ETH-PBL/SwiftEagle/Hardware/Baseboard/Schematics.PDF

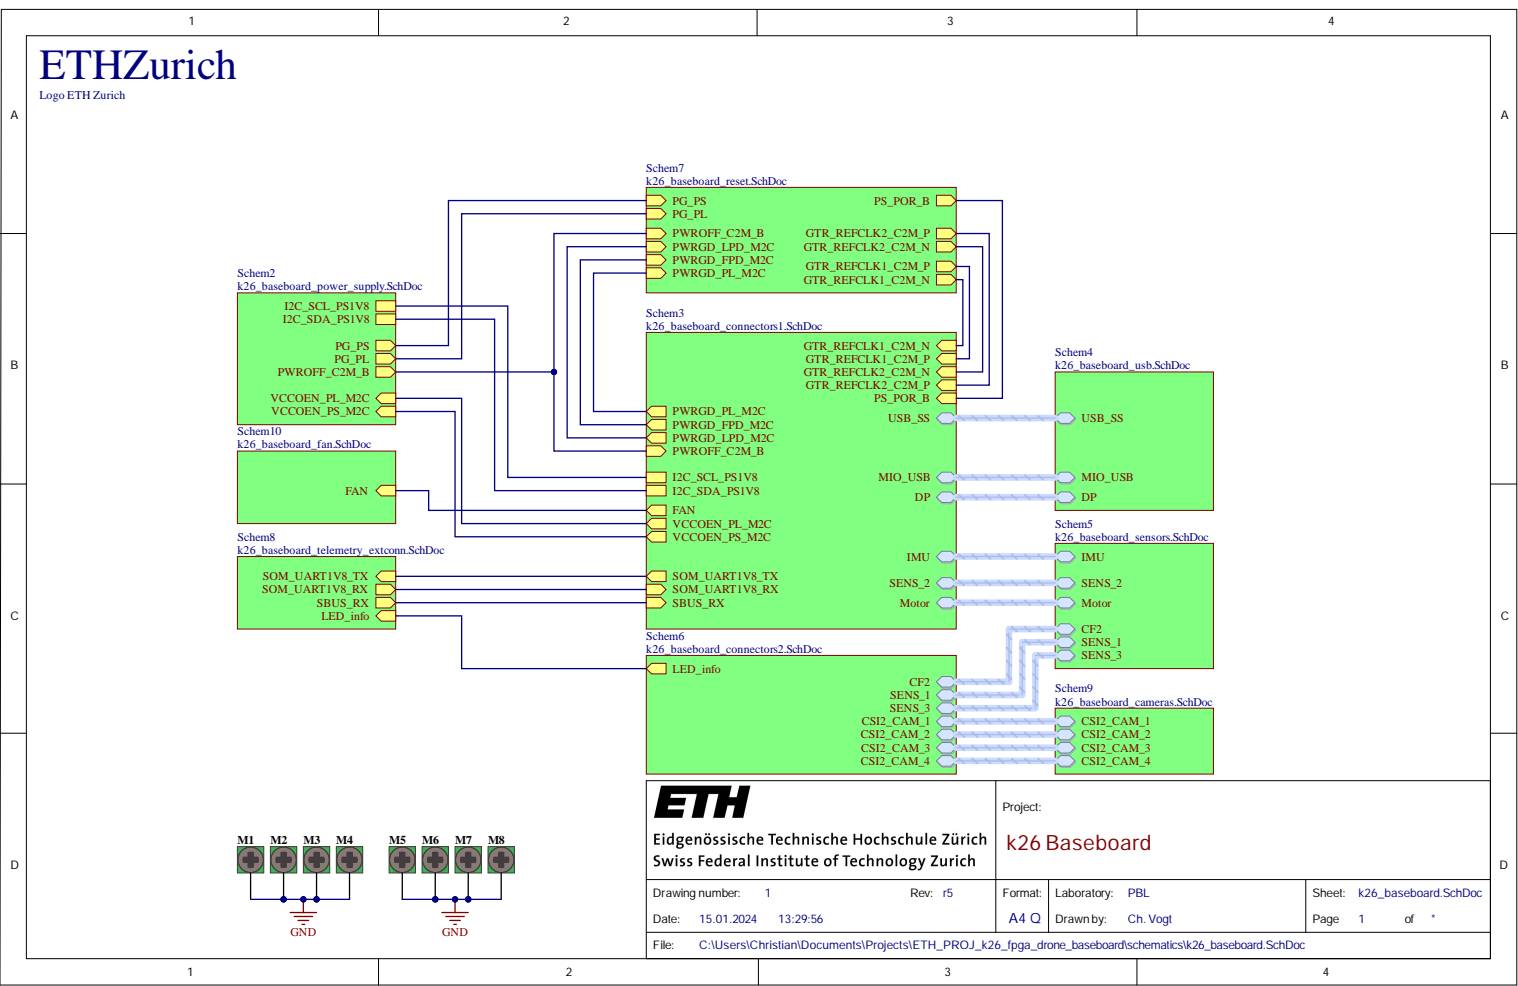
[picture p3: page 1]

ETHZurich Logo ETH Zurich

Project: k26 Baseboard

Drawing number: 1 Rev: r5 Date: 15.01.2024 13:29:56 | Format: A4 Q | Laboratory: PBL Drawn by: Ch.Vogt | Sheet: k26_baseboard.SchDoc Page 1 of *

C:\Users\Christian\Documents\Projects\ETH_PROJ_k26_fpga_drone_baseboard\schematics\k26_baseboard.SchDoc

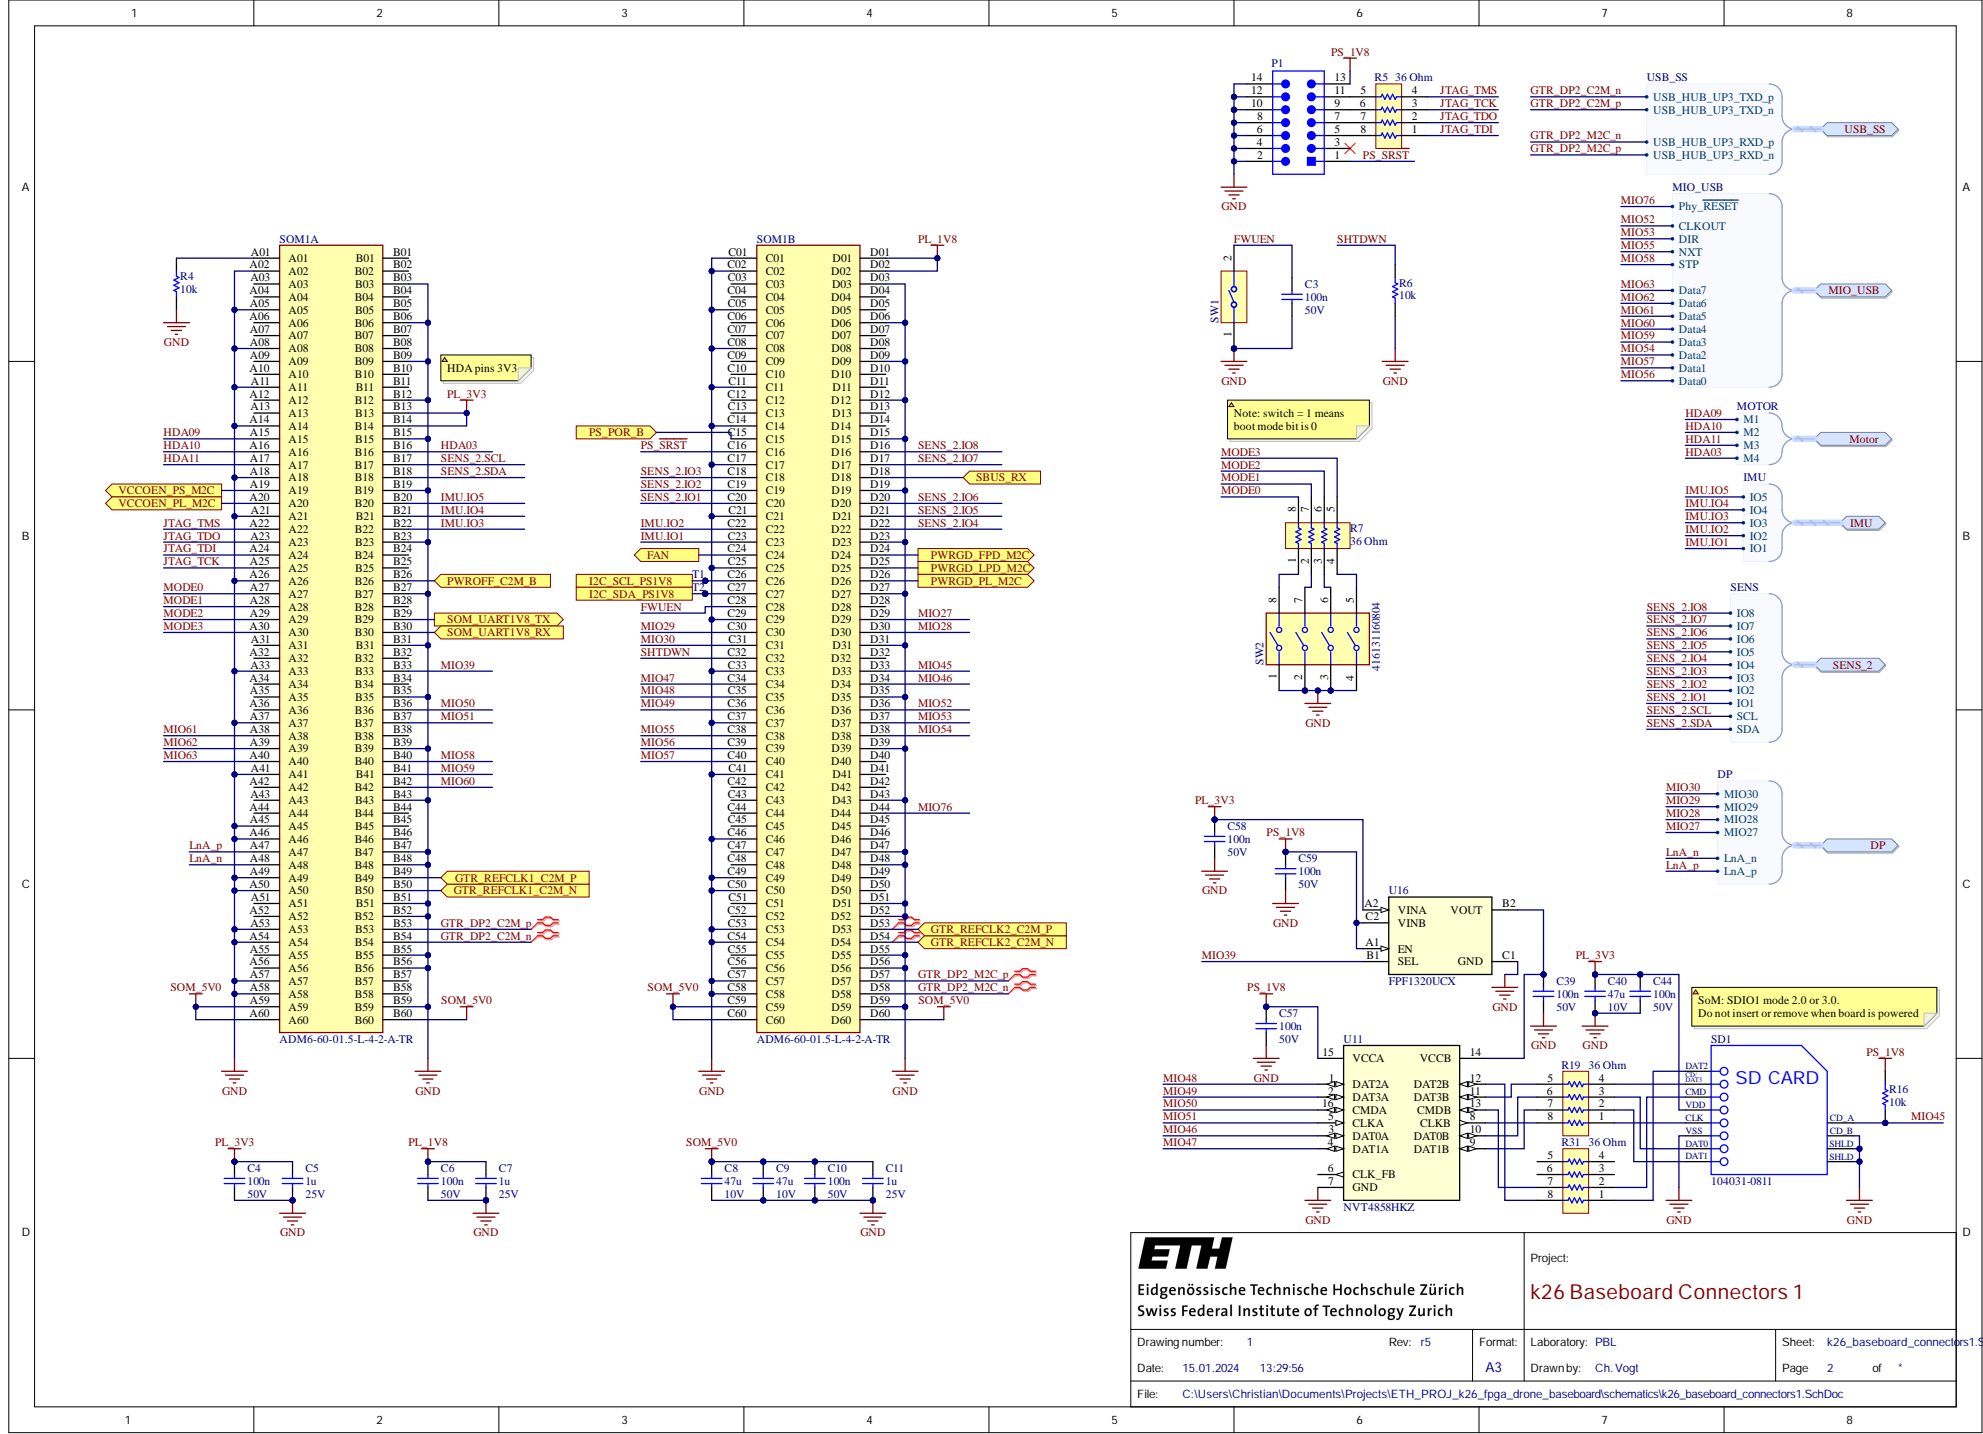
[picture p4: page 2]

12 | 11
10 | 9 6
8 | | 7 7
6 | 5 8

Note: switch = 1 means
boot mode bit is 0

SoM: SDIO1 mode 2.0 or 3.0.
Do not insert or remove when board is powered

GND 7 | 7 | 2

Project: k26 Baseboard Connectors 1

Drawing number: 1 Rev: r5 | Format: A3 | Laboratory: PBL | Sheet: Page 2 of *

C:\Users\Christian\Documents\Projects\ETH_PROJ_k26_fpga_drone_baseboard\schematics\k26_baseboard_connectors1.SchDoc

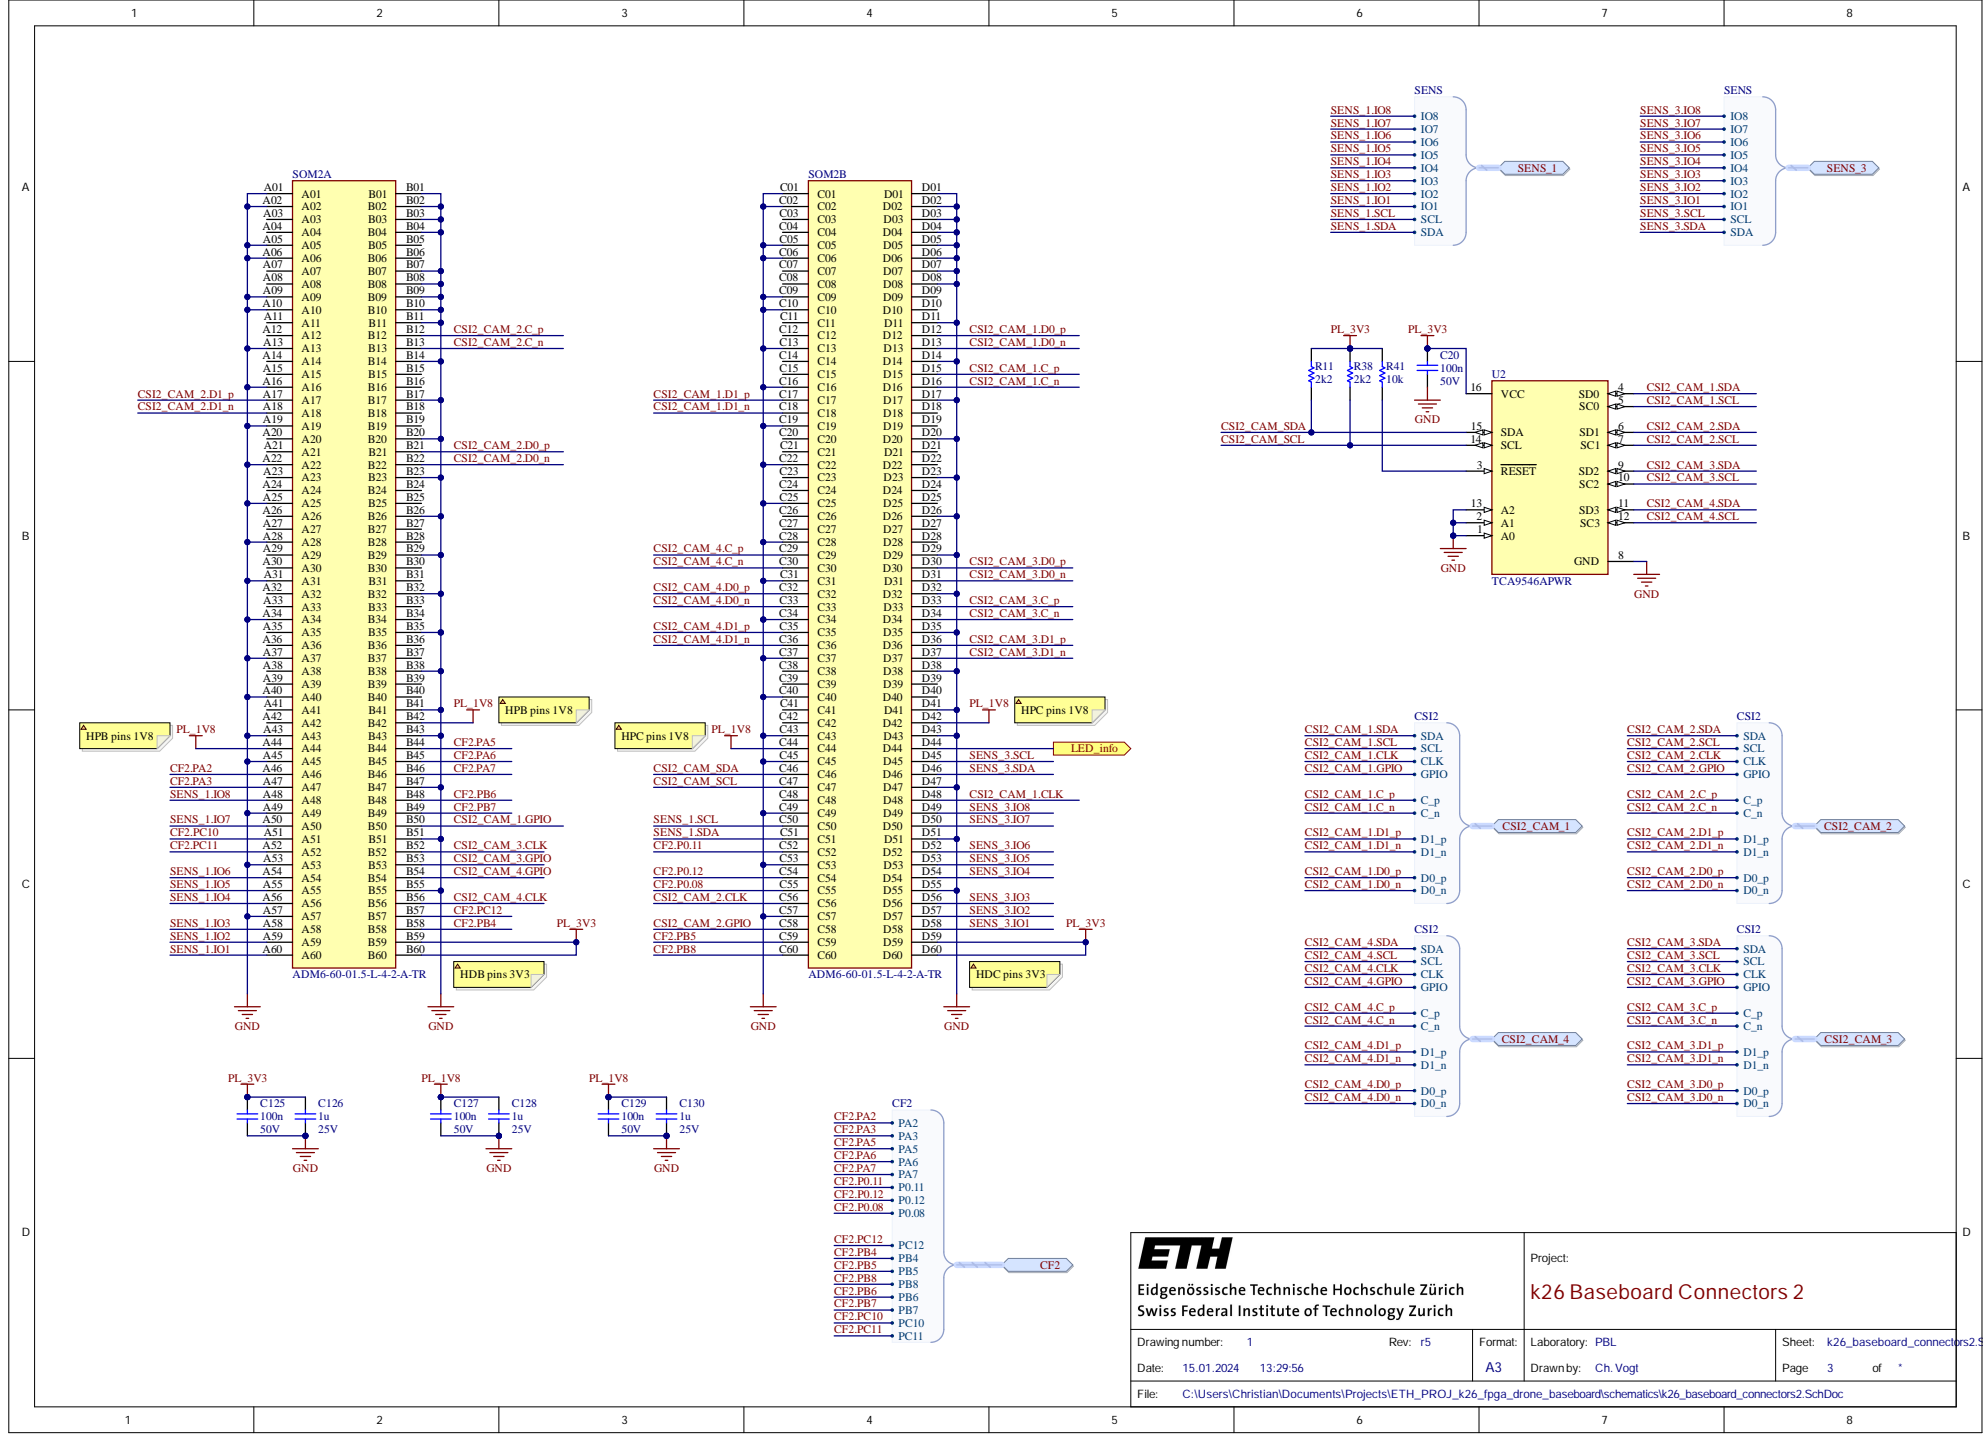
[picture p5: page 3]

Project: k26 Baseboard Connectors 2

Page 3 of *

C:\Users\Christian\Documents\Projects\ETH_PROJ_k26_fpga_drone_baseboard\schematics\k26_baseboard_connectors2.SchDoc

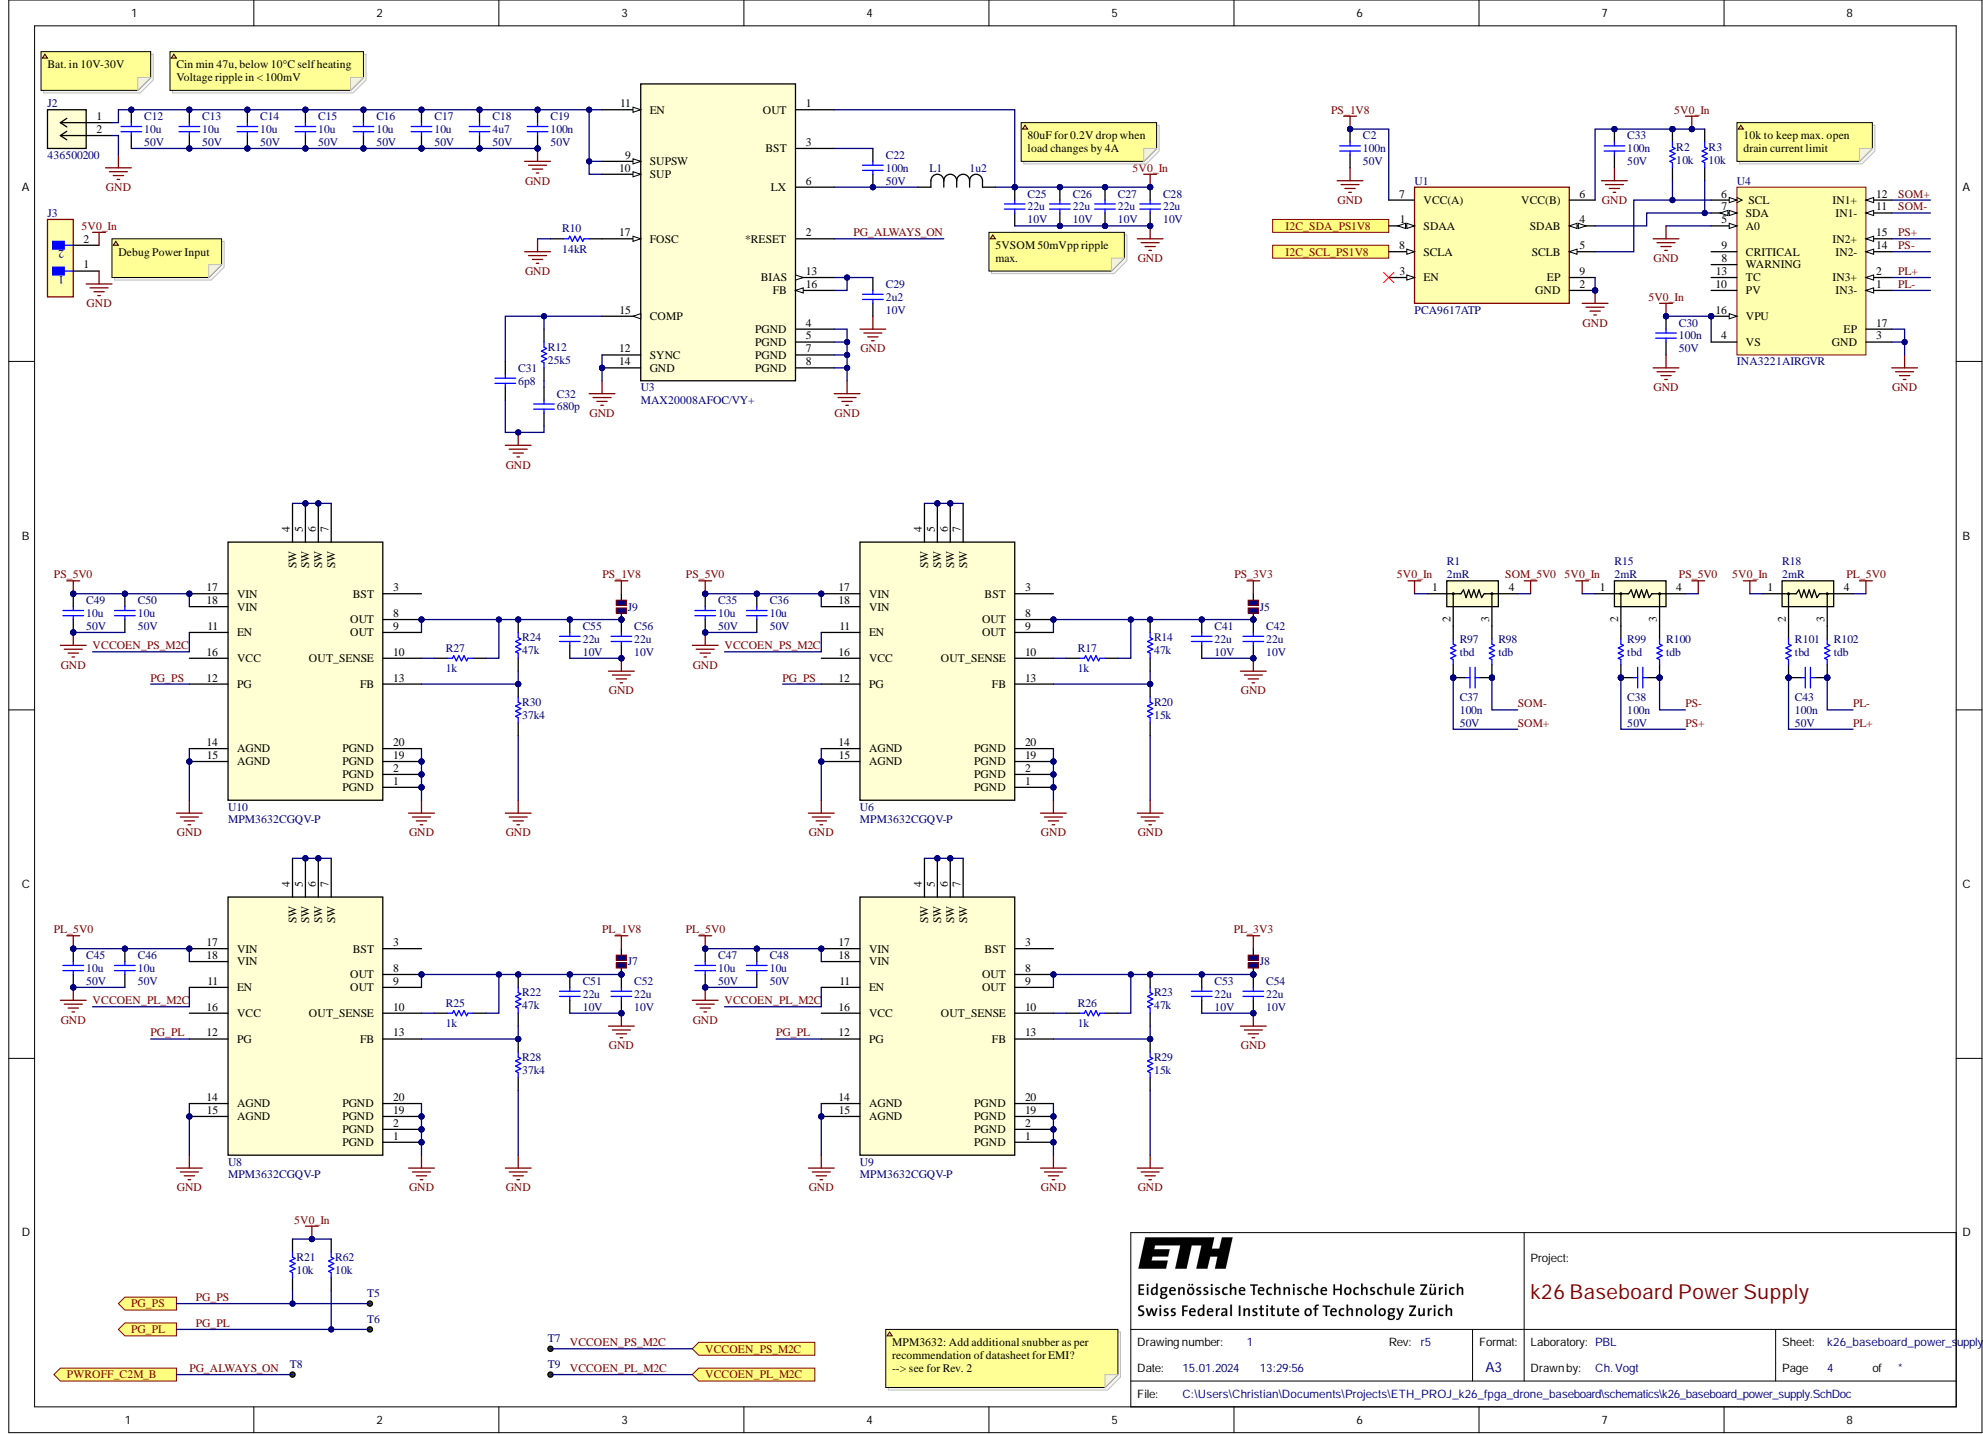
[picture p6: page 4]

10k to keep max. open
drain current limit

max. Debug Power Input

EN 3 | GND

Project: k26 Baseboard Power Supply

MPM3632: Add additional snubber as per
recommendation of datasheet for EMI?
--> see for Rev. 2

Page 4 of *

C:\Users\Christian\Documents\Projects\ETH_PROJ_k26_fpga_drone_baseboard\schematics\k26_baseboard_power_supply.SchDoc

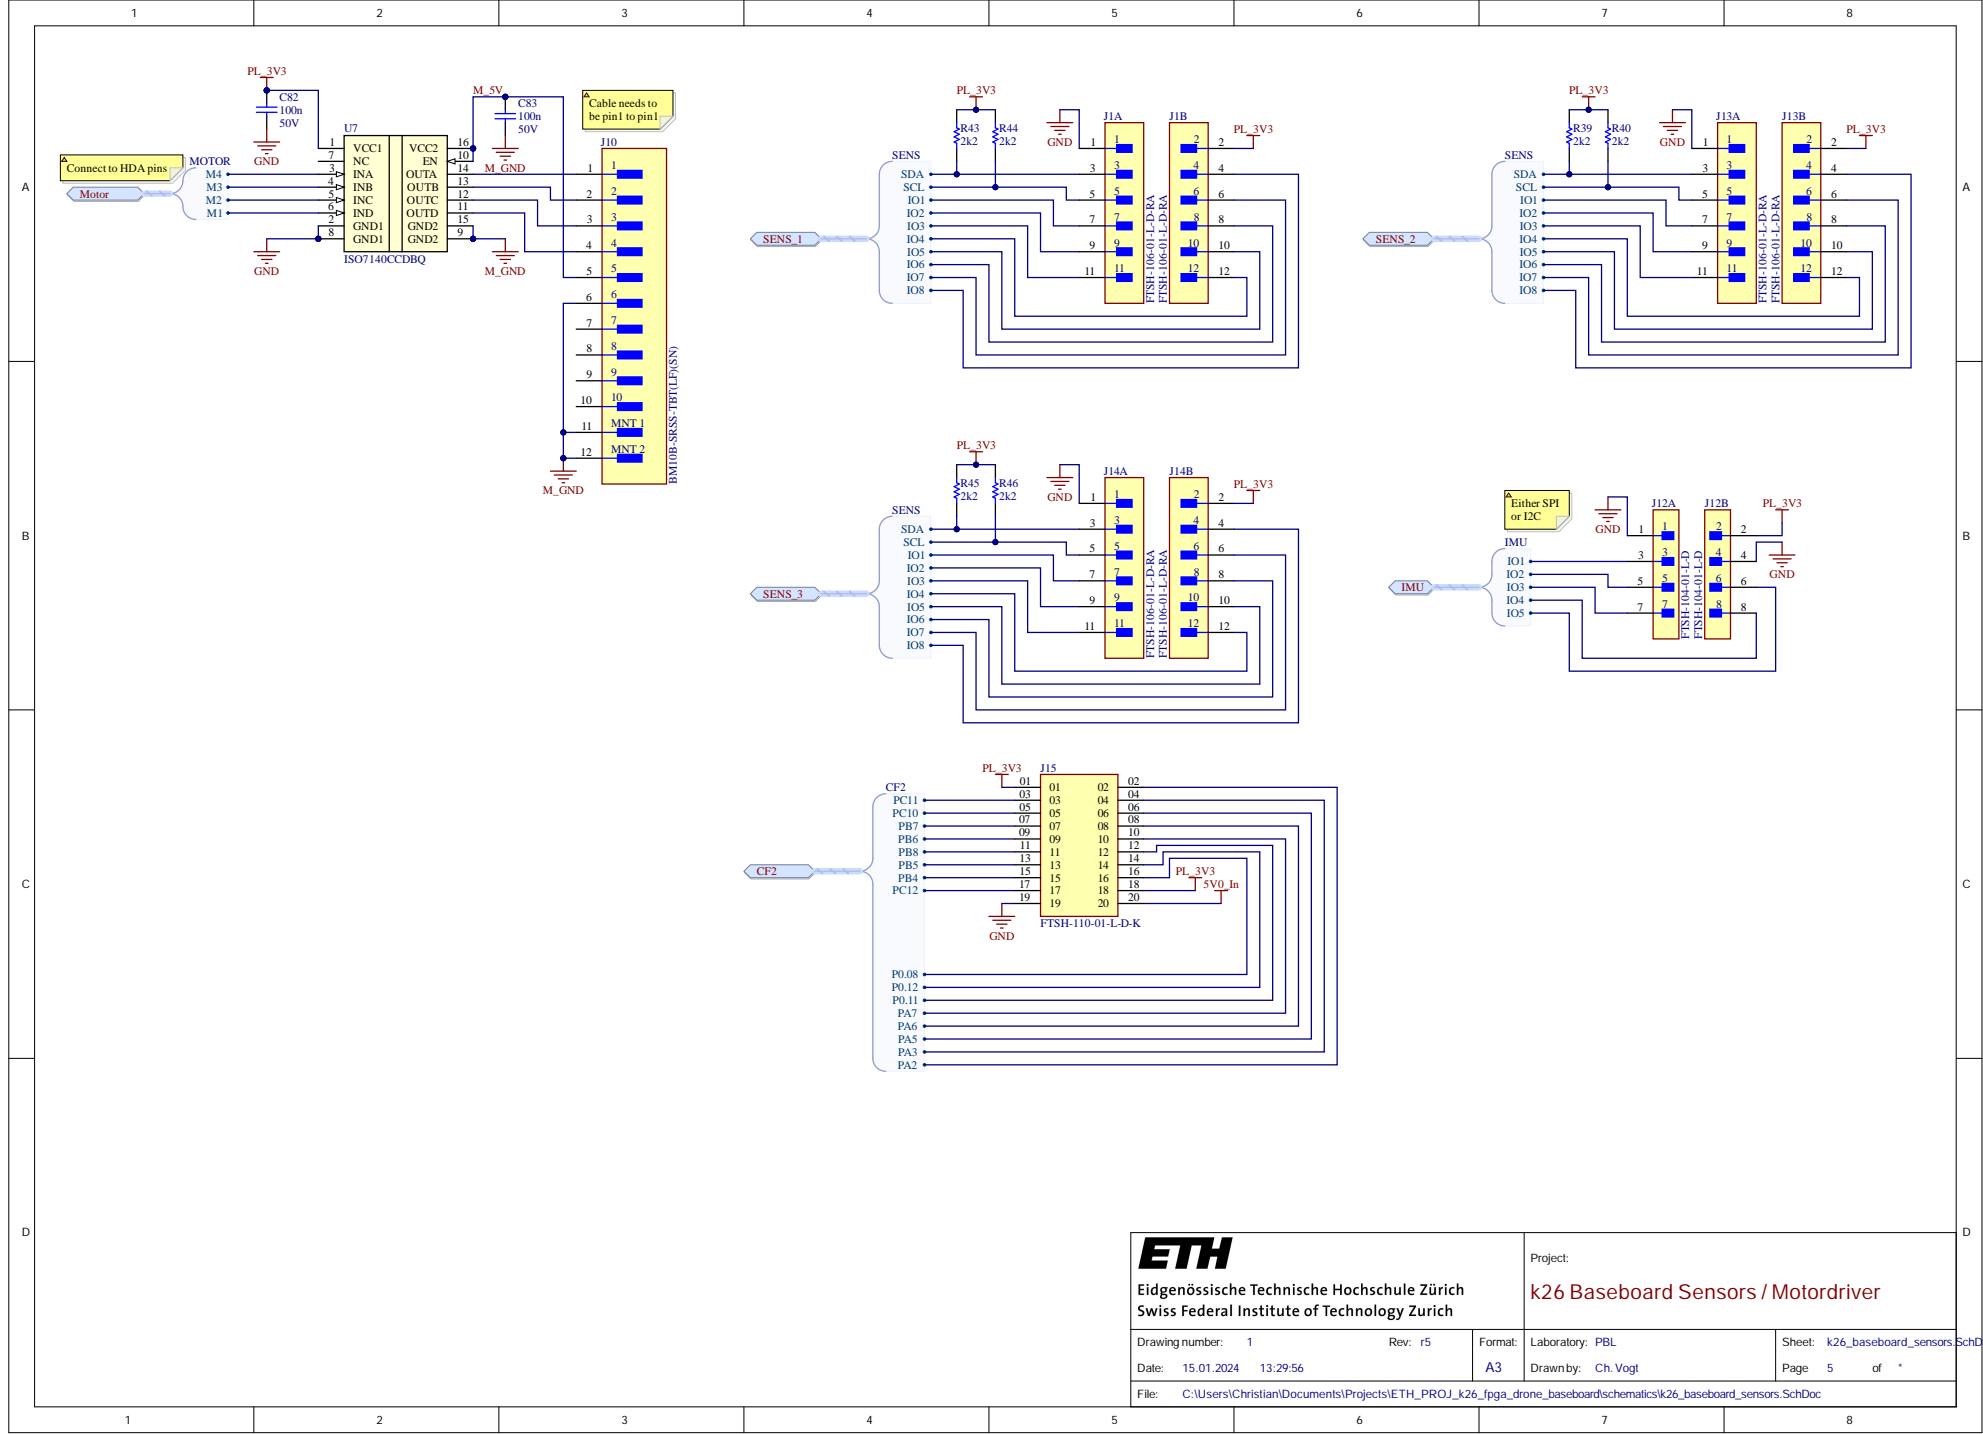
[picture p7: page 5]

Connect to HDA pins

BM10B-SRSS-TBT(LF)(SN)

03 03 04 | 04
05 05 06 | 06
07 07 08 | 08
09 09 10 | 10
11 11

Project: k26 Baseboard Sensors / Motordriver

Page 5 of *

C:\Users\Christian\Documents\Projects\ETH_PROJ_k26_fpga_drone_baseboard\schematics\k26_baseboard_sensors.SchDoc

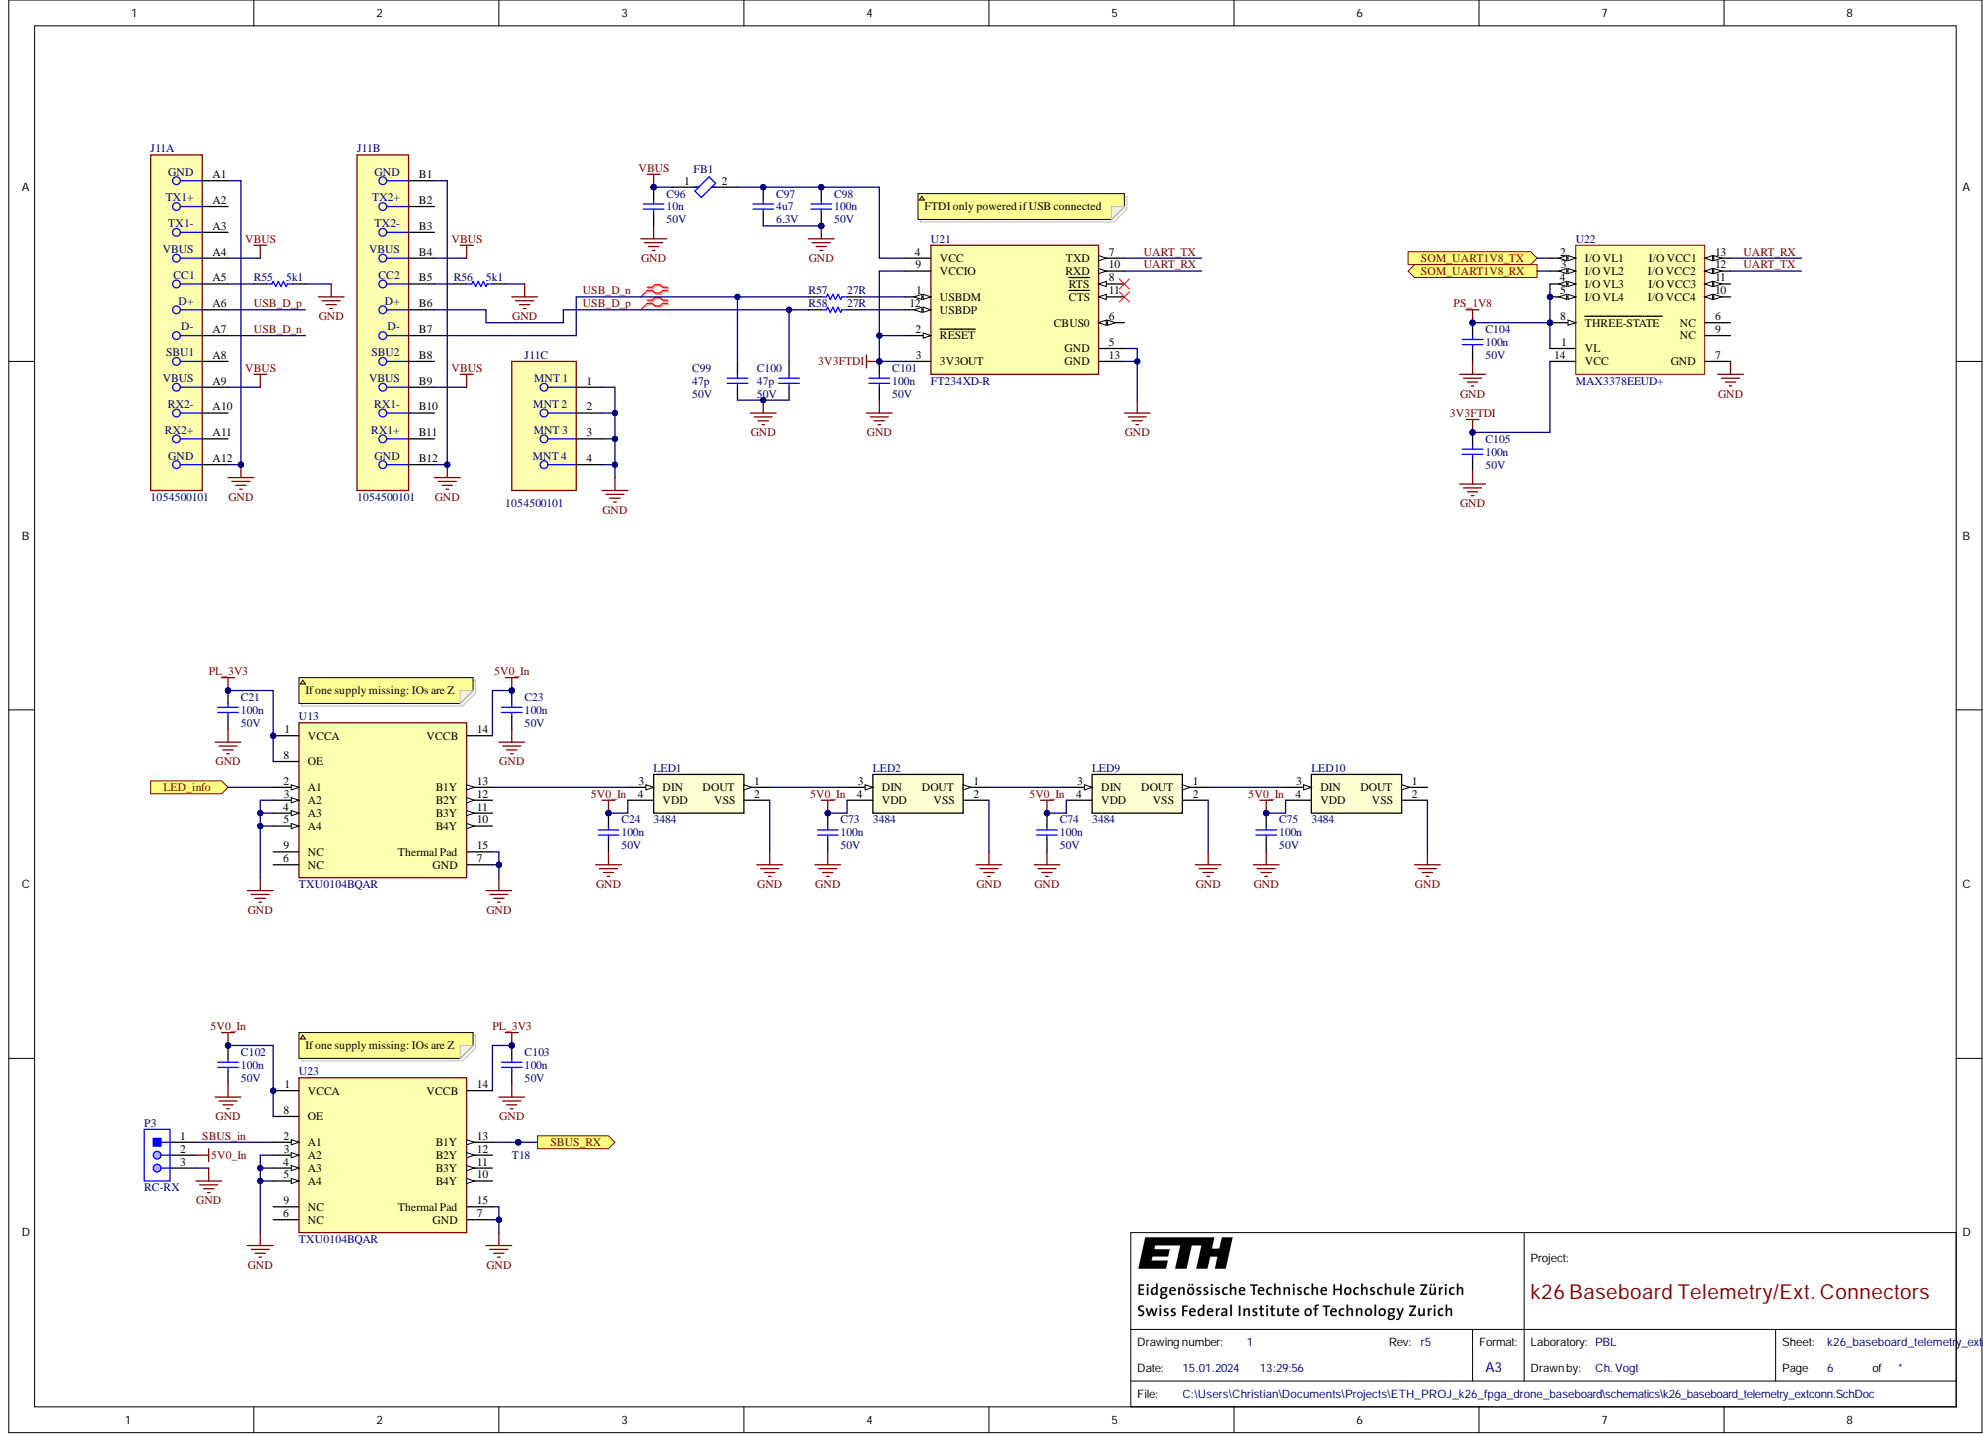
[picture p8: page 6]

FTDI only powered if USB connected

USBDM 1

RESET 2

If one supply missing: IOs are Z

Project: k26 Baseboard Telemetry/Ext. Connectors

Page 6 of *

C:\Users\Christian\Documents\Projects\ETH_PROJ_k26_fpga_drone_baseboard\schematics\k26_baseboard_telemetry_extconn.SchDoc

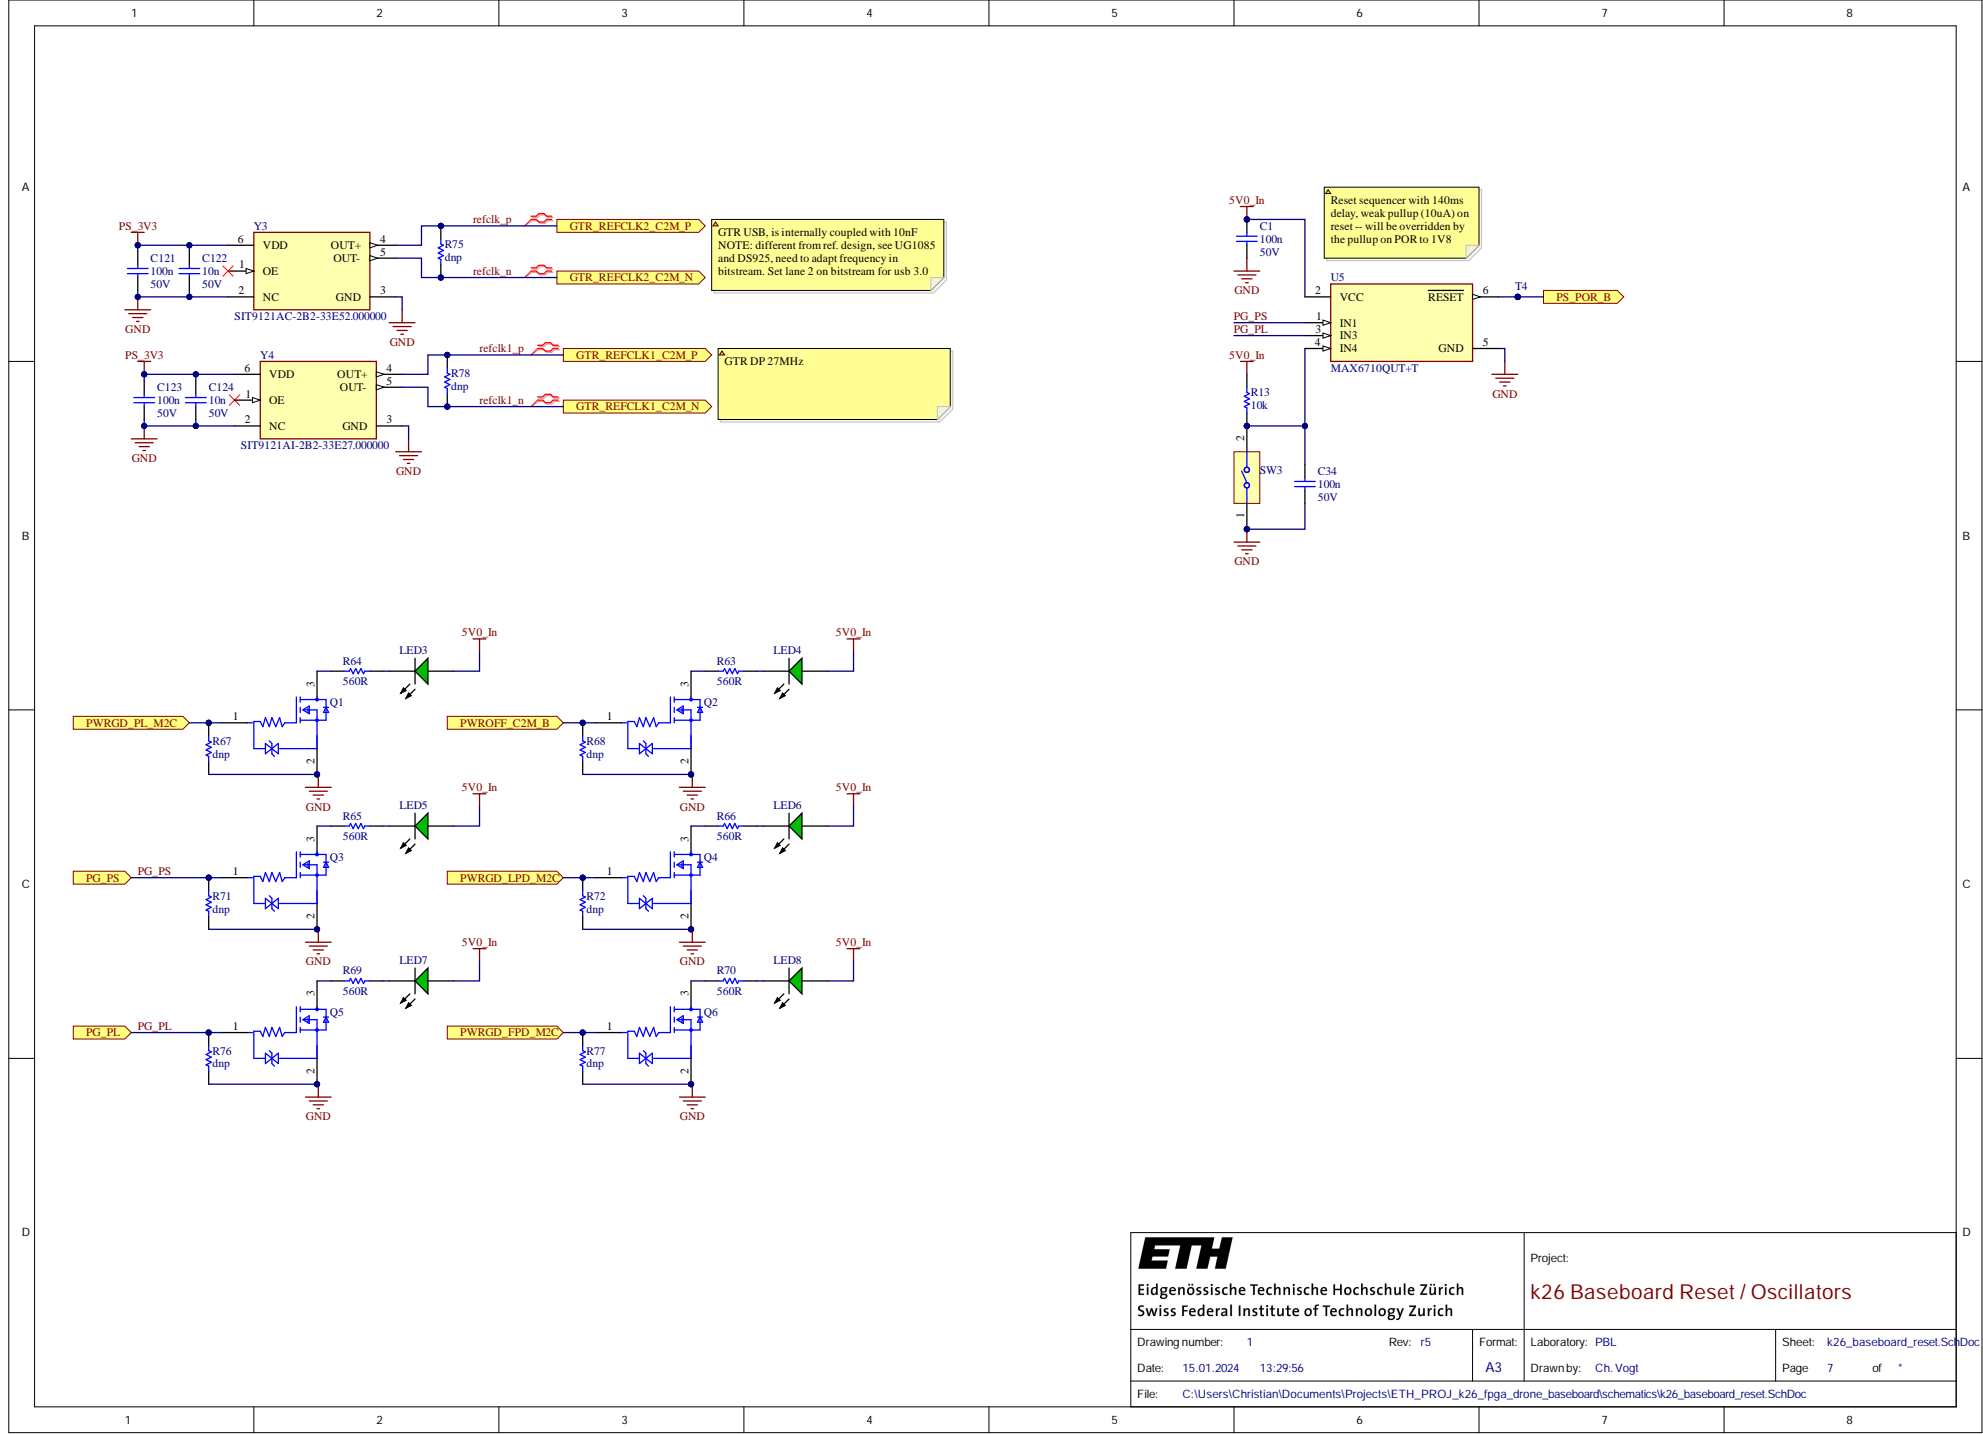
[picture p9: page 7]

Proje c t: / k 2 6 B a s e b o a rd R e s e t O s c i l l a to rs

Drawing num b e r: 1 R e v : r5 D a te : 15.01. 202 4 : 5 6 | Form a t: A 3 | Laborato ry : PB L Drawn by : Ch.Vog t | Shee t: k26_baseboard_re s e t. S c Pag e 7 of * | h

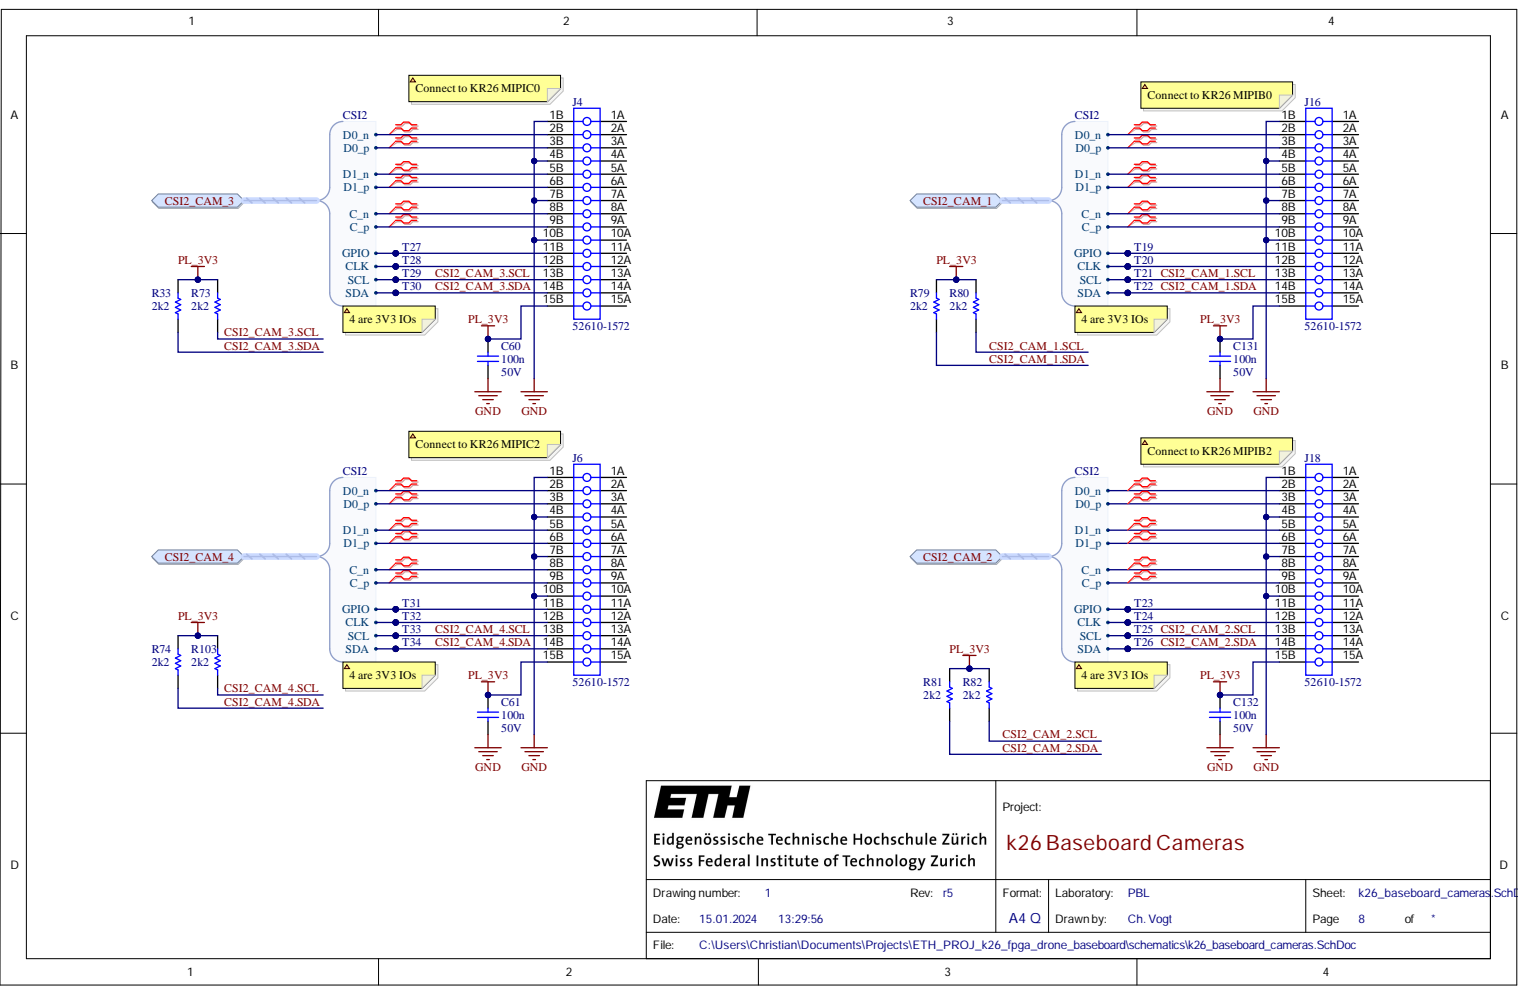
[picture p10: page 8]

Proje c t: k 2 6 B a s e b o a rd C a m e ra s

Drawing num b e r: 1 R e v : r5 D a te : 15.01. 202 4 : 5 6 | Form a t: A 4 Q | Laborato ry : PB L Drawn by : Ch.Vog t | Shee t: k26_baseboard_c a m e ra s Pag e 8 of *

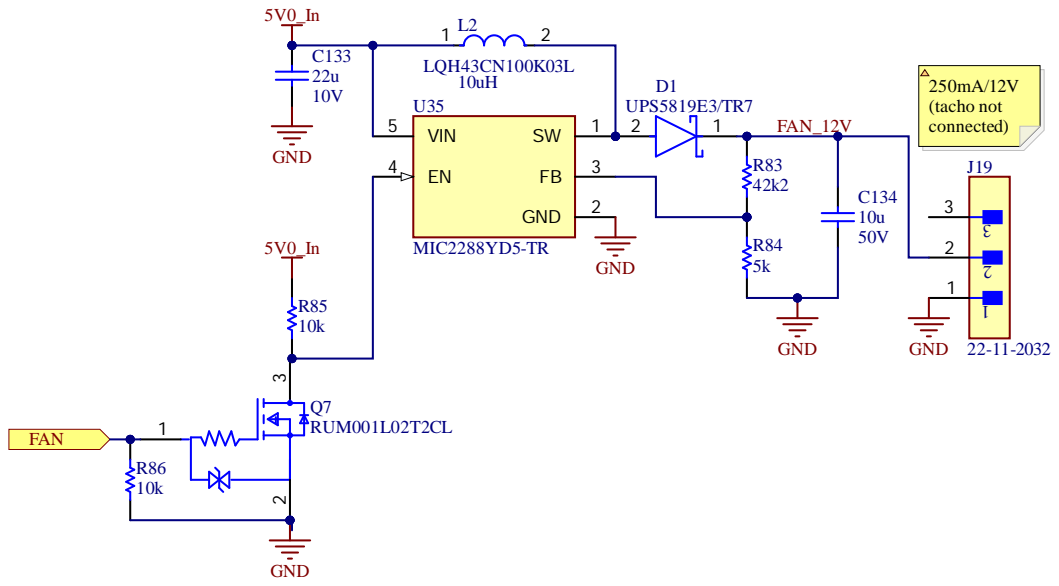
[picture p11: page 9]

Proje c t: k 2 6 B a s e b o a rd F a n

Drawing num b e r: 1 R e v : r5 D a te : 15.01. 202 4 : 5 7 | Form a t: A 4 Q | Laborato ry : PB L Drawn by : Ch.Vog t | Shee t: k26_baseboard_ fa n . S c h D Pag e 9 of *

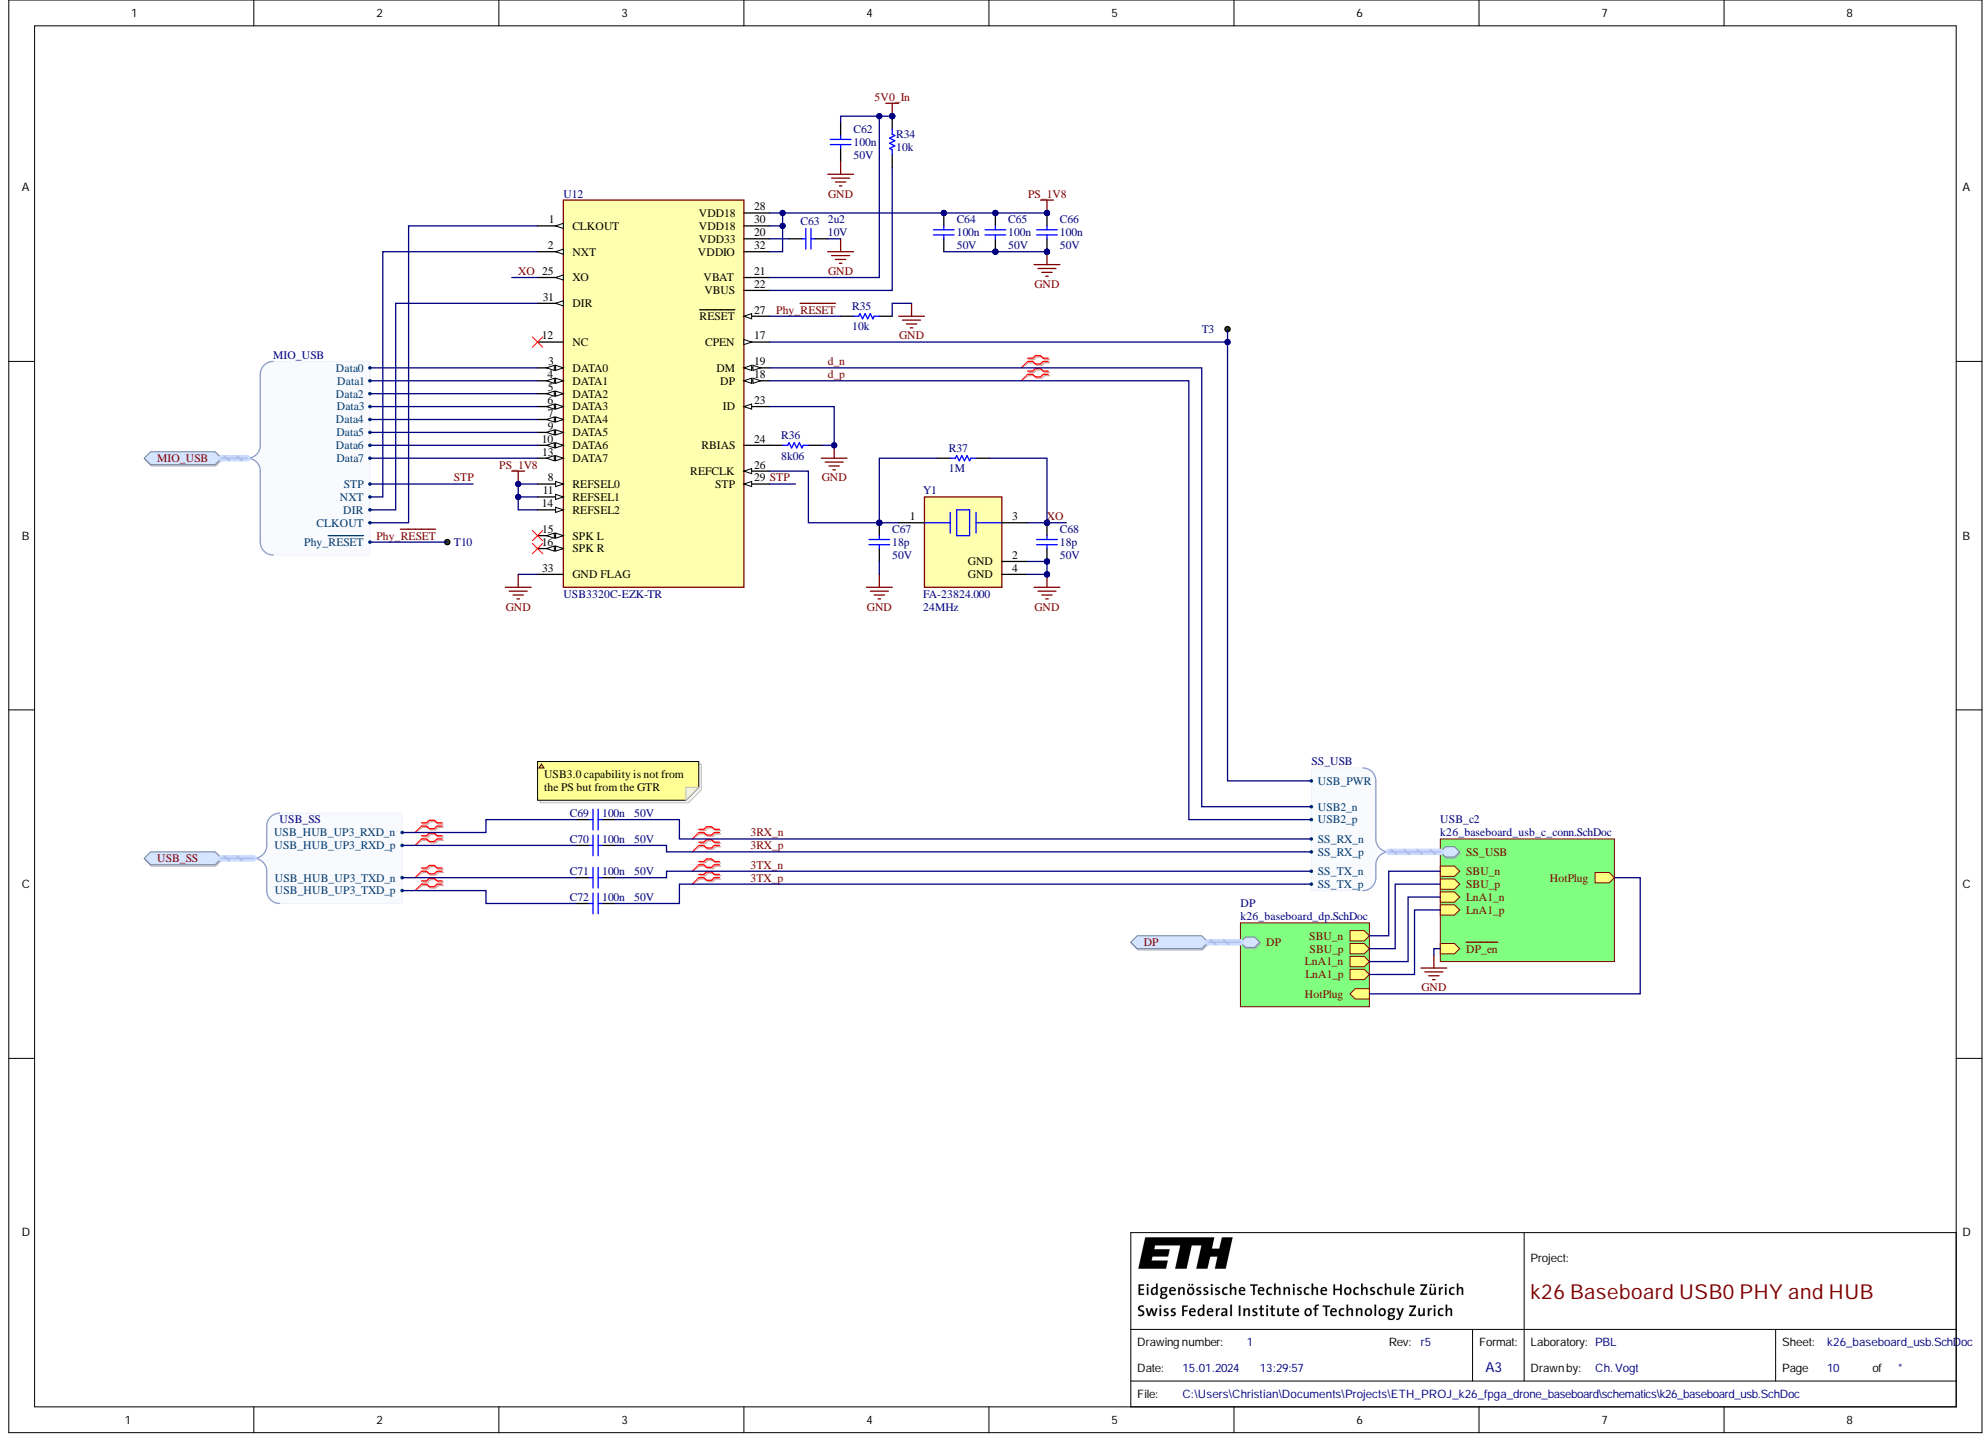
[picture p12: page 10]

DATA6 10

PS_1V8 | REFSEL0 8

REFSEL1 11

USB3.0 capability is not from
the PS but from the GTR

Project: k26 Baseboard USB0 PHY and HUB

k26_baseboard_usb.SchDoc Page 10 of *

C:\Users\Christian\Documents\Projects\ETH_PROJ_k26_fpga_drone_baseboard\schematics\k26_baseboard_usb.SchDoc

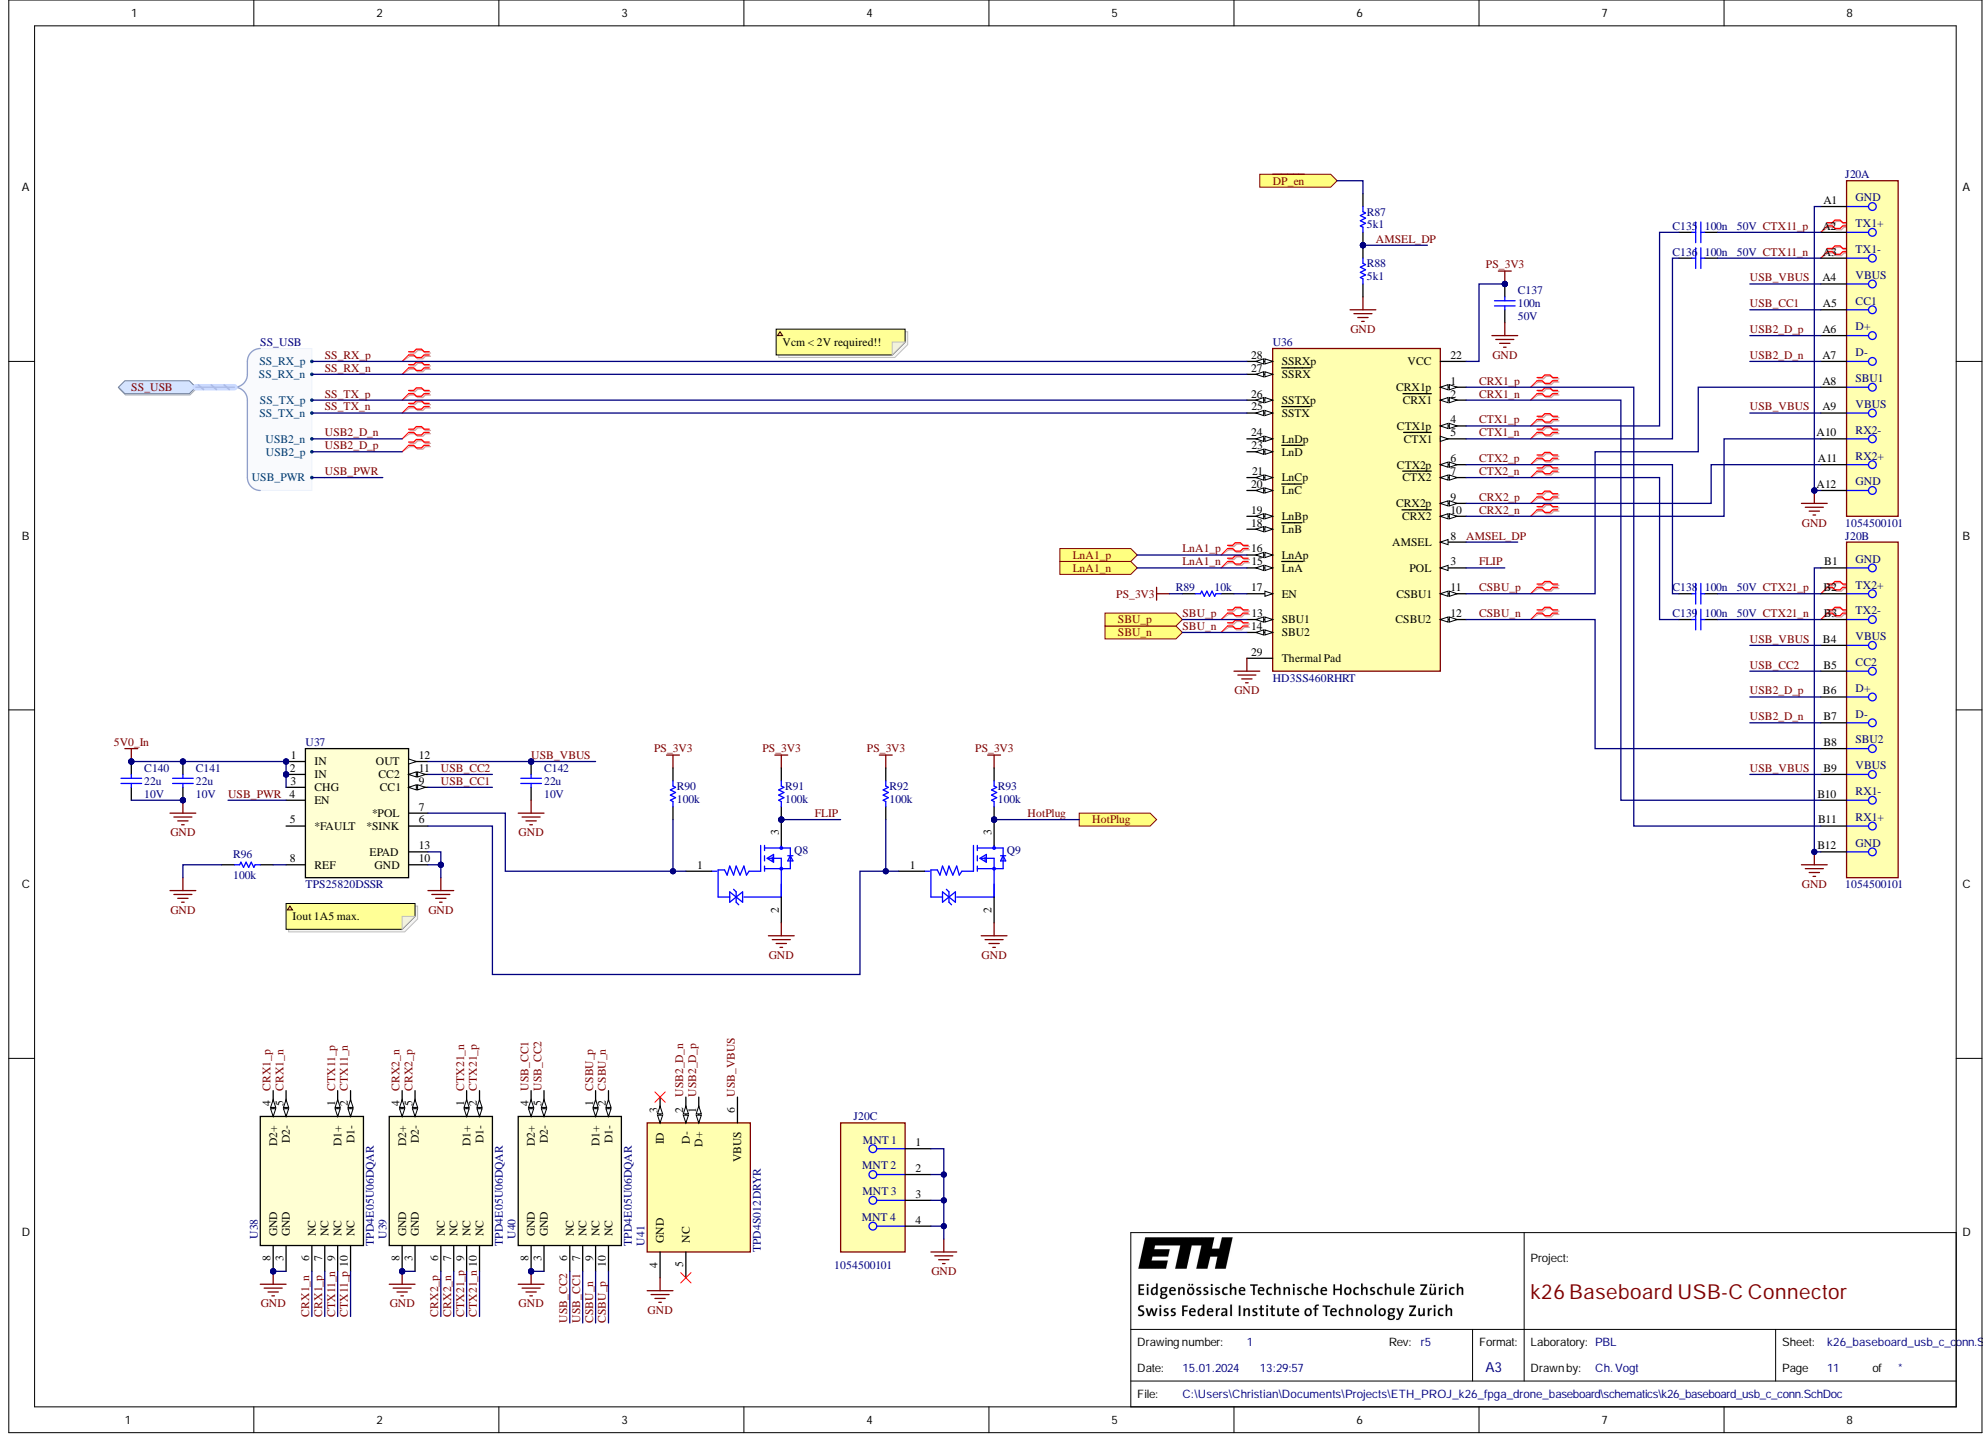
[picture p13: page 11]

Project: k26 Baseboard USB-C Connector

Page 11 of *

C:\Users\Christian\Documents\Projects\ETH_PROJ_k26_fpga_drone_baseboard\schematics\k26_baseboard_usb_c_conn.SchDoc

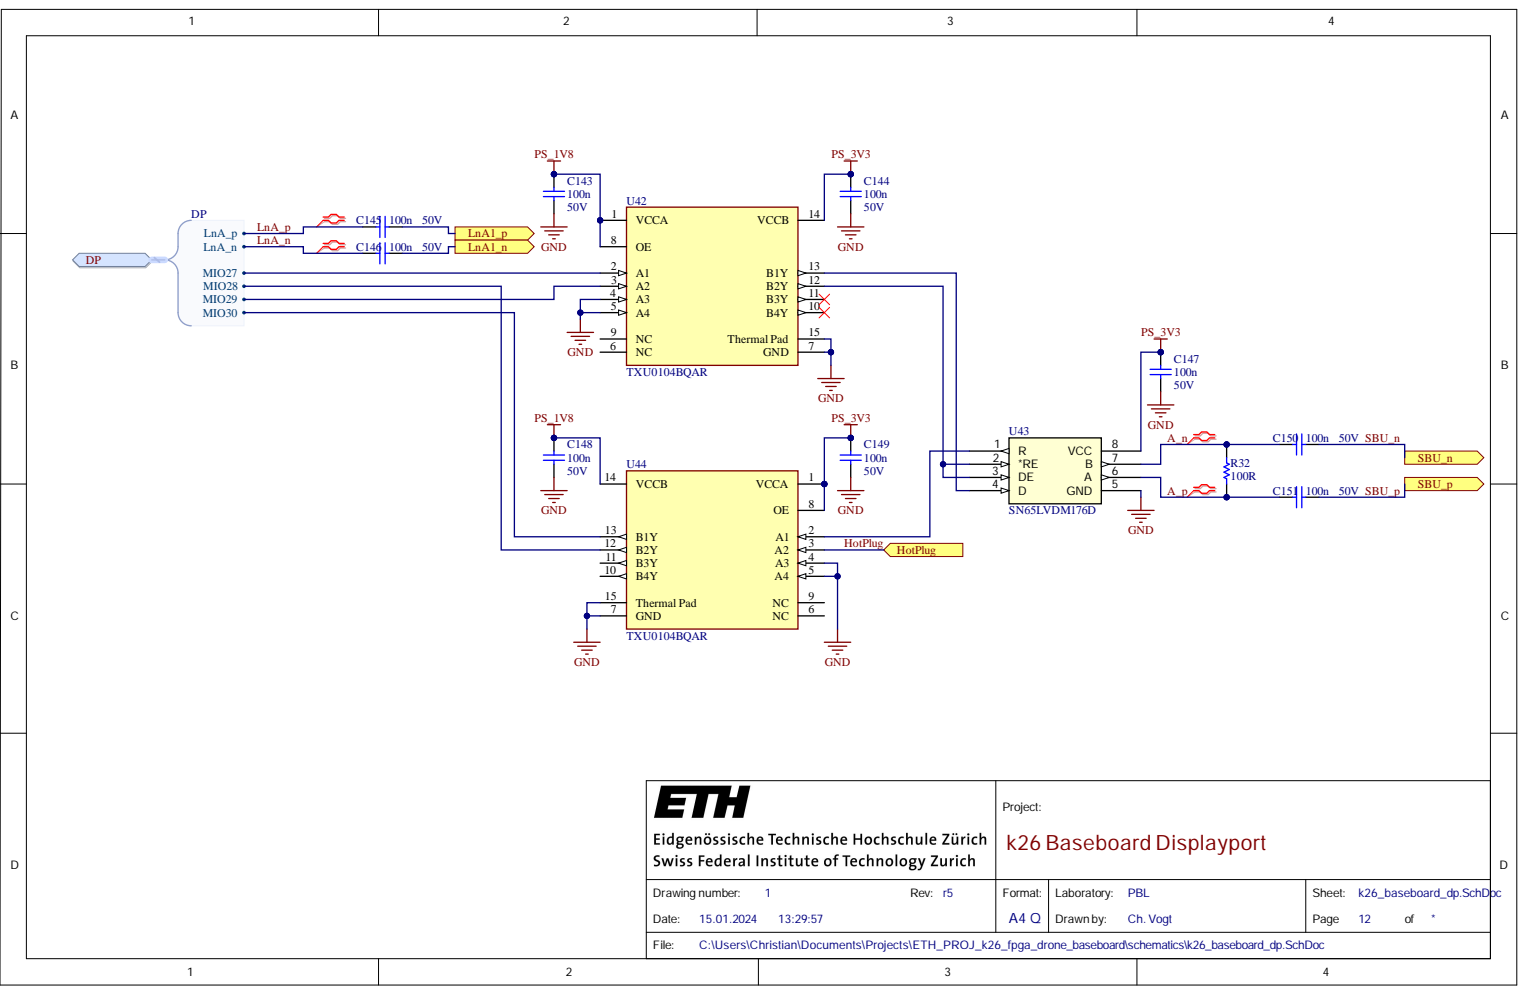
[picture p14: page 12]

Project: k26 Baseboard Displayport

Drawing number: 1 Rev: r5 | Format: A4 Q | Laboratory: PBL | Sheet: k26_baseboard_dp.SchDoc Page 12 of *

C:\Users\Christian\Documents\Projects\ETH_PROJ_k26_fpga_drone_baseboard\schematics\k26_baseboard_dp.SchDoc

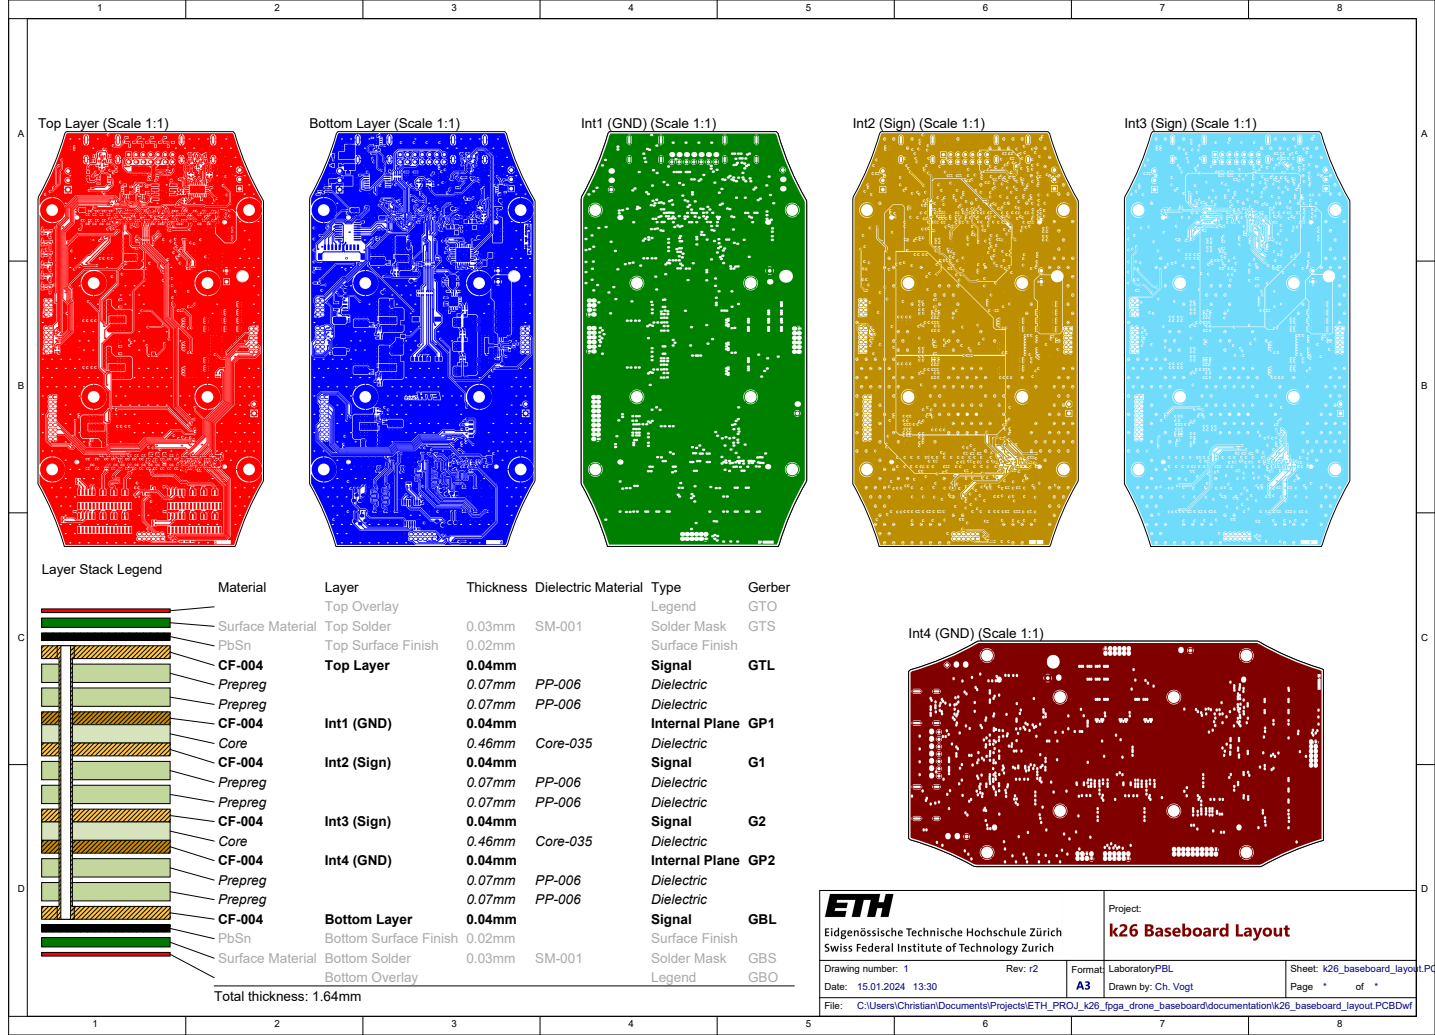
[picture p15: page 13]

C:\Users\Christian\Documents\Projects\ETH_PROJ_k26_fpga_drone_baseboard\documentation\k26_baseboard_layout.PCBDwf

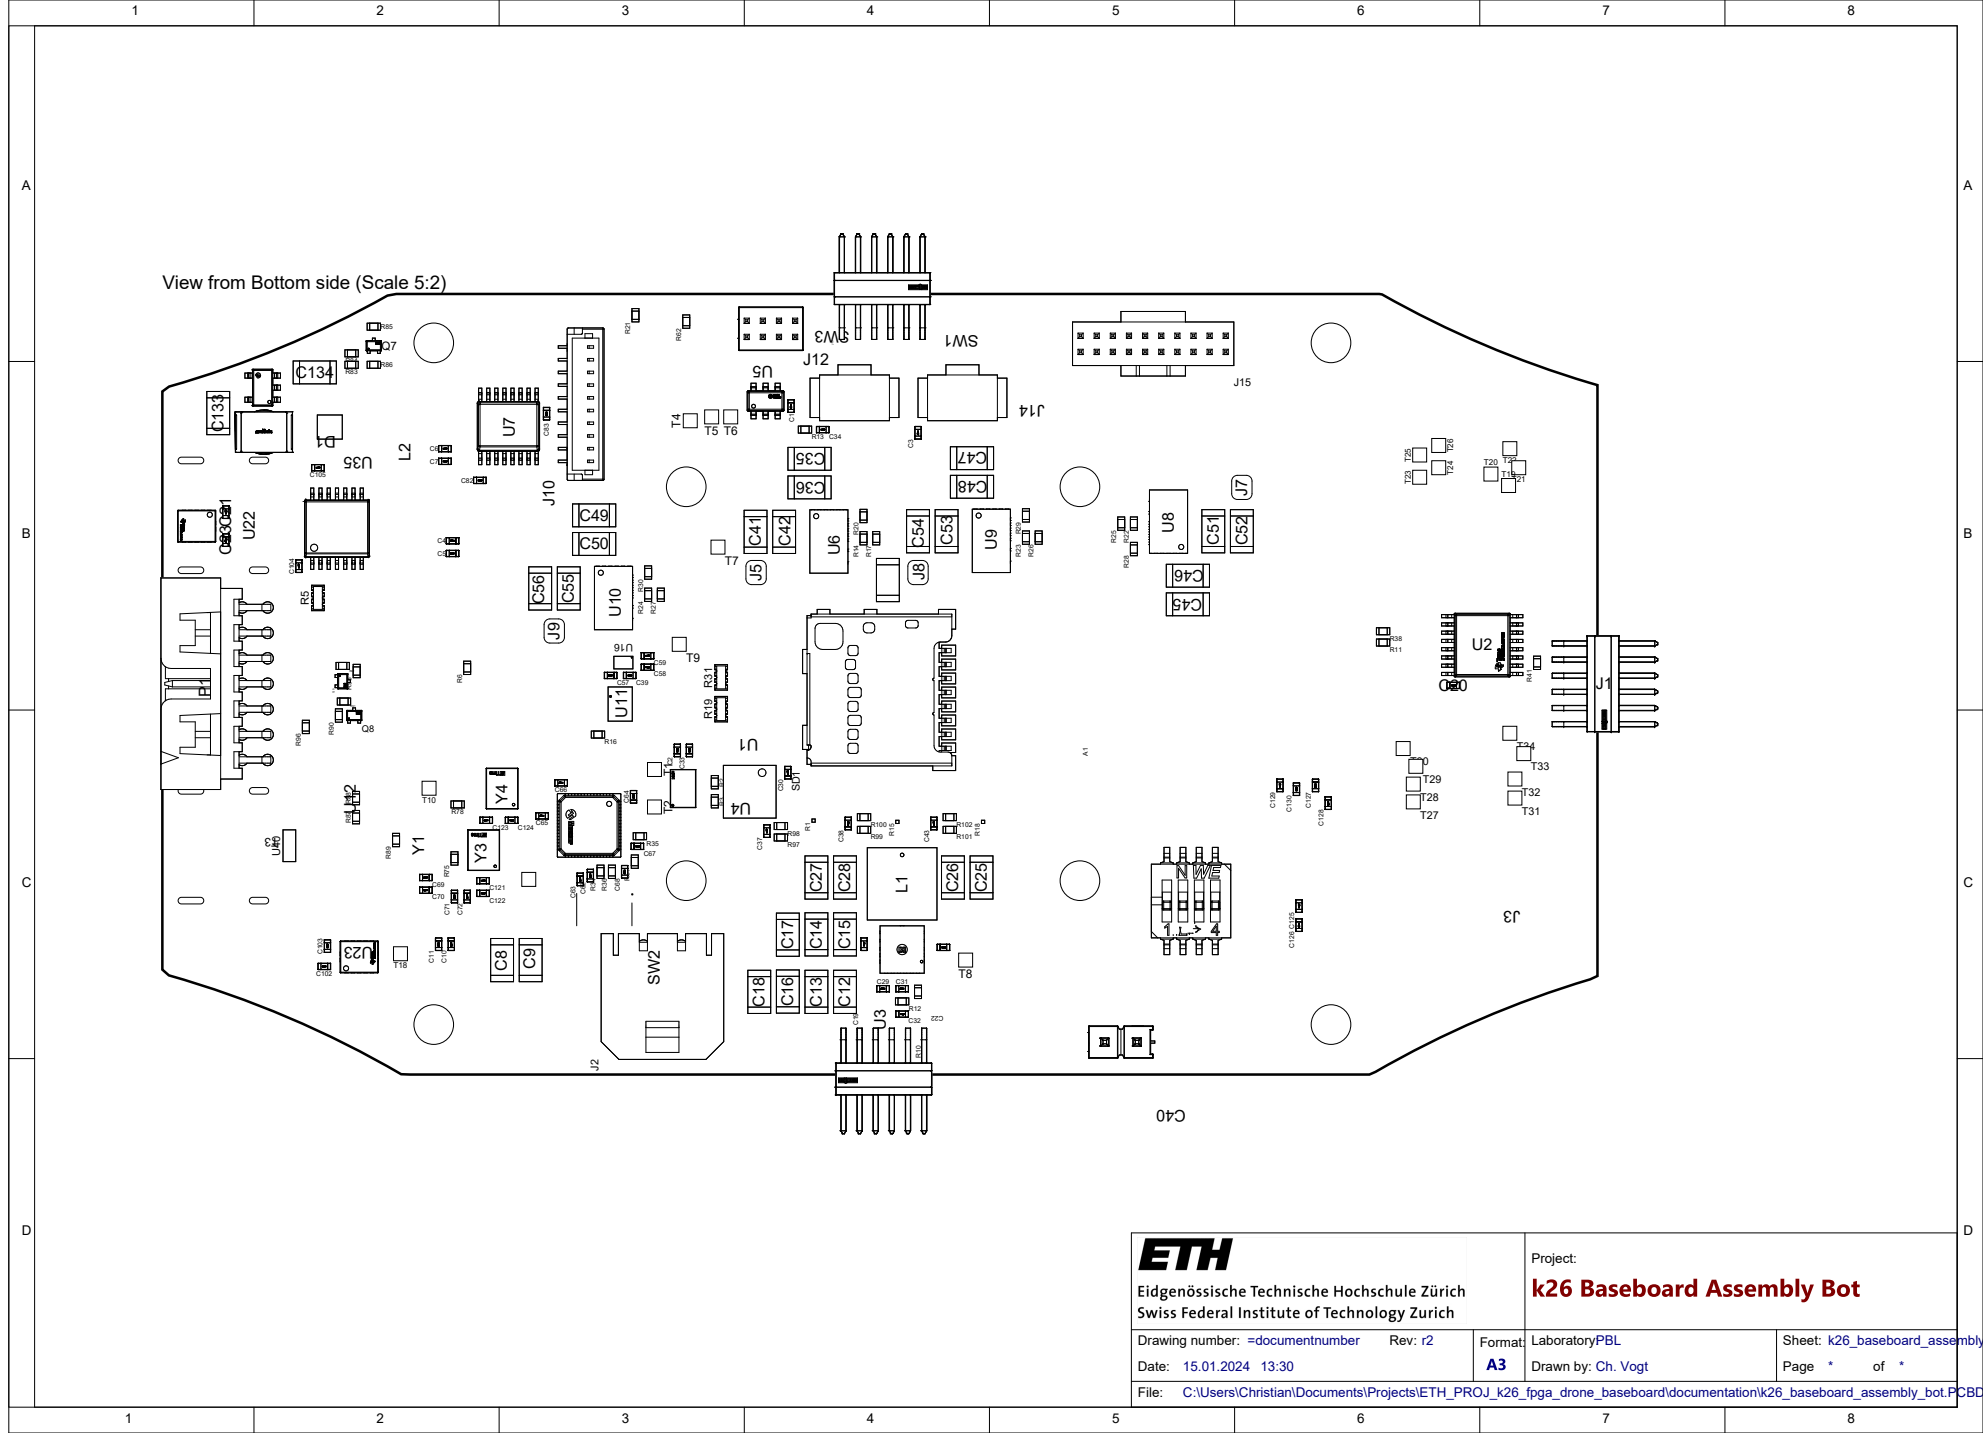
[picture p16: page 14]

View from Bottom side (Scale 5:2)

C:\Users\Christian\Documents\Projects\ETH_PROJ_k26_fpga_drone_baseboard\documentation\k26_baseboard_assembly_bot.PCBDwf

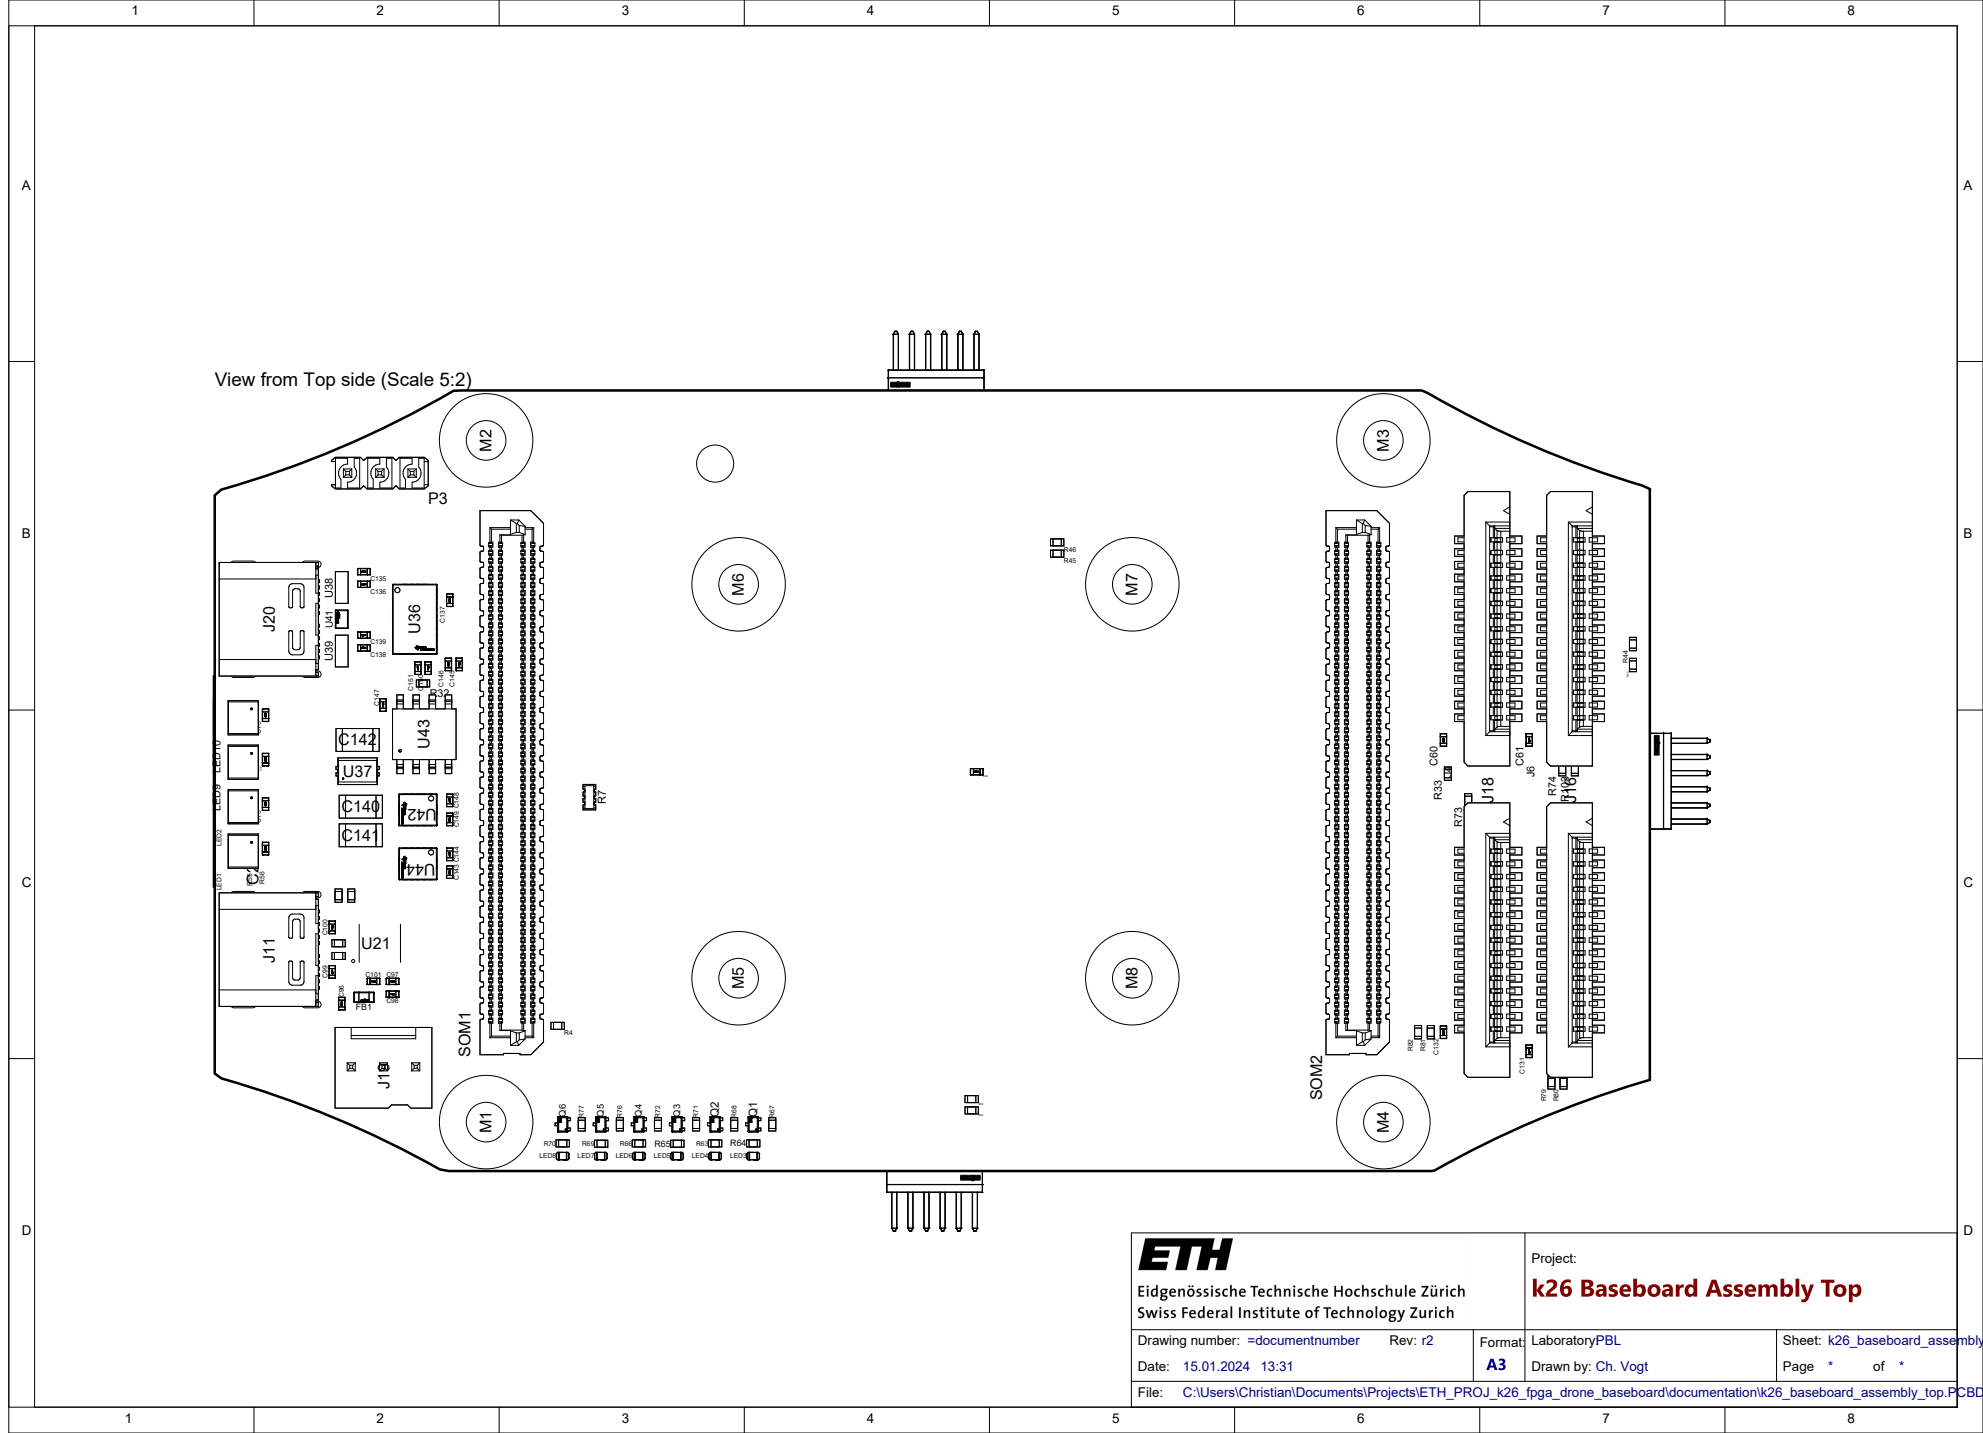
[picture p17: page 15]

View from Top side (Scale 5:2)

C:\Users\Christian\Documents\Projects\ETH_PROJ_k26_fpga_drone_baseboard\documentation\k26_baseboard_assembly_top.PCBDwf

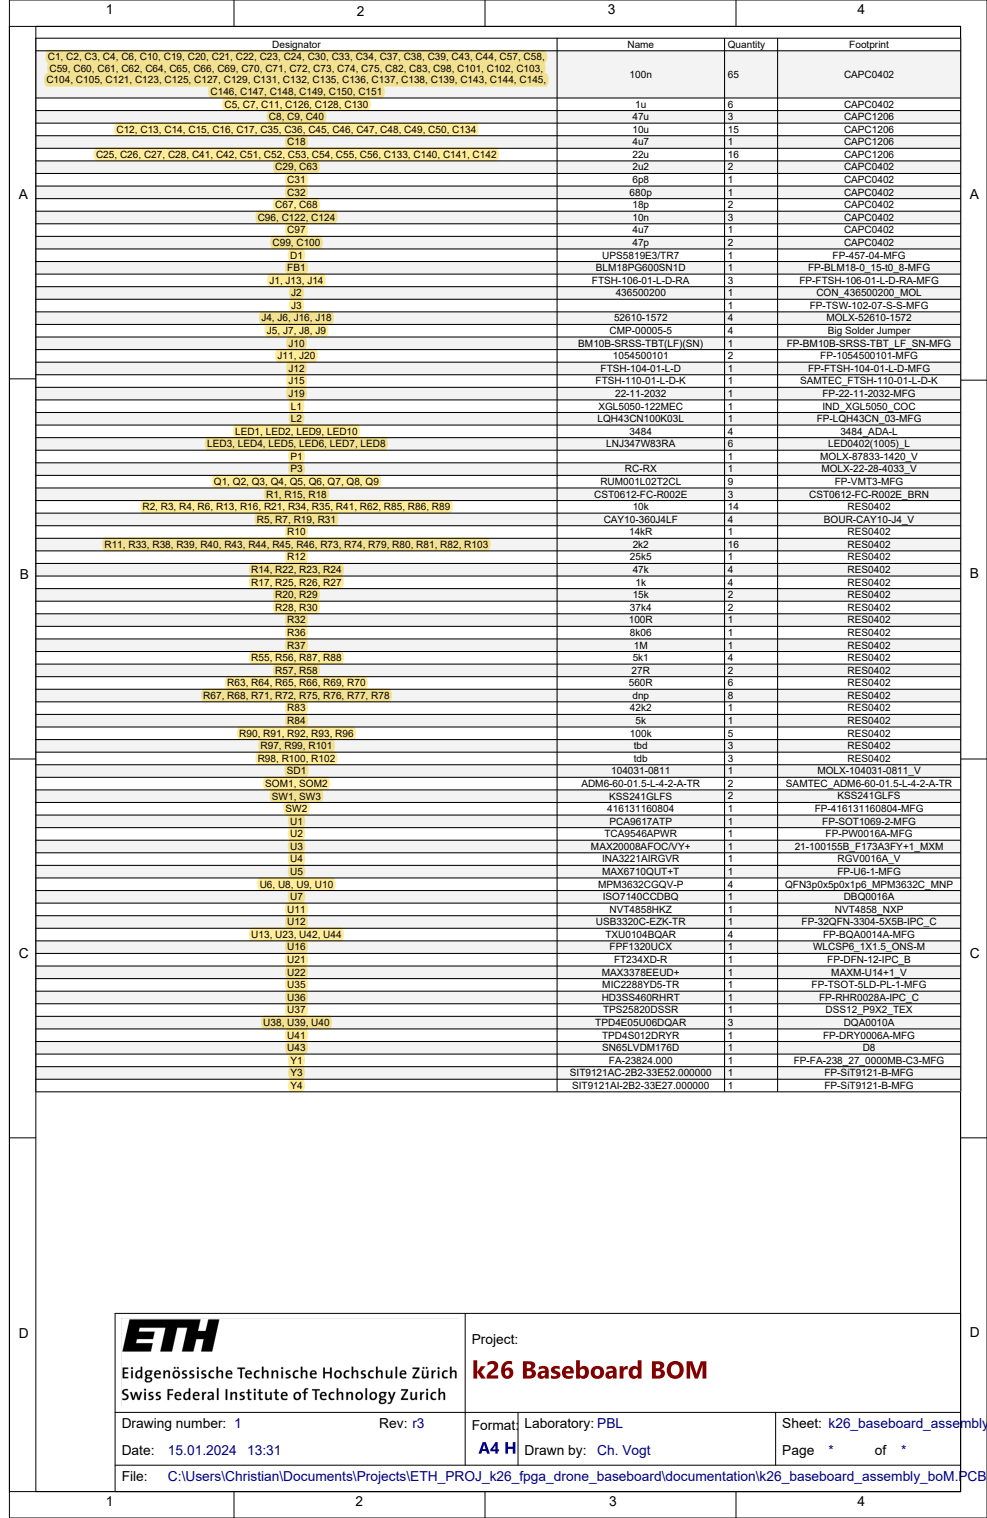
[picture p18: page 16]

C1, C2, C3, C4, C6, C10, C19, C20, C21, C22, C23, C24, C30, C33, C34, C37, C38, C39, C43, C44, C57, C58, C59, C60, C61, C62, C64, C65, C66, C69, C70, C71, C72, C73, C74, C75, C82, C83, C98, C101, C102, C103, C104, C105, C121, C123, C125, C127, C129, C131, C132, C135, C136, C137, C138, C139, C143, C144, C145, C146, C147, C148, C149, C150, C151 | 100n | 65 | CAPC0402

Designator | Name | Quantity | Footprint

C5, C7, C11, C126, C128, C130 | 1u | 6 | CAPC0402

C12, C13, C14, C15, C16, C17, C35, C36, C45, C46, C47, C48, C49, C50, C134 | 10u | 15 | CAPC1206

C8, C9, C40 | 47u | 3 | CAPC1206

C18 | 4u7 | 1 | CAPC1206

C25, C26, C27, C28, C41, C42, C51, C52, C53, C54, C55, C56, C133, C140, C141, C142 | 22u | 16 | CAPC1206

C29, C63 | 2u2 | 2 | CAPC0402
C31 | 6p8 | 1 | CAPC0402
C32 | 680p | 1 | CAPC0402
C67, C68 | 18p | 2 | CAPC0402
C96, C122, C124 | 10n | 3 | CAPC0402
C97 | 4u7 | 1 | CAPC0402
C99, C100 | 47p | 2 | CAPC0402
D1 | UPS5819E3/TR7 | 1 | FP-457-04-MFG
FB1 | BLM18PG600SN1D | 1 | FP-BLM18-0_15-t0_8-MFG
J1, J13, J14 | FTSH-106-01-L-D-RA | 3 | FP-FTSH-106-01-L-D-RA-MFG
J2 | 436500200 | 1 | CON_436500200_MOL
J3 | | 1 | FP-TSW-102-07-S-S-MFG
J4, J6, J16, J18 | 52610-1572 | 4 | MOLX-52610-1572
J5, J7, J8, J9 | CMP-00005-5 | 4 | Big Solder Jumper
J10 | BM10B-SRSS-TBT(LF)(SN) | 1 | FP-BM10B-SRSS-TBT_LF_SN-MFG
J11, J20 | 1054500101 | 2 | FP-1054500101-MFG
J12 | FTSH-104-01-L-D | 1 | FP-FTSH-104-01-L-D-MFG
J15 | FTSH-110-01-L-D-K | 1 | SAMTEC_FTSH-110-01-L-D-K
J19 | 22-11-2032 | 1 | FP-22-11-2032-MFG
L1 | XGL5050-122MEC | 1 | IND_XGL5050_COC
L2 | LQH43CN100K03L | 1 | FP-LQH43CN_03-MFG

LED1, LED2, LED9, LED10 | 3484 | 4 | 3484_ADA-L
LED3, LED4, LED5, LED6, LED7, LED8 | LNJ347W83RA | 6 | LED0402(1005)_L

P1 | | 1 | MOLX-87833-1420_V
P3 | RC-RX | 1 | MOLX-22-28-4033_V

Q1, Q2, Q3, Q4, Q5, Q6, Q7, Q8, Q9 | RUM001L02T2CL | 9 | FP-VMT3-MFG

R1, R15, R18 | CST0612-FC-R002E | 3 | CST0612-FC-R002E_BRN

R2, R3, R4, R6, R13, R16, R21, R34, R35, R41, R62, R85, R86, R89 | 10k | 14 | RES0402

R5, R7, R19, R31 | CAY10-360J4LF | 4 | BOUR-CAY10-J4_V
R10 | 14kR | 1 | RES0402

R11, R33, R38, R39, R40, R43, R44, R45, R46, R73, R74, R79, R80, R81, R82, R103 | 2k2 | 16 | RES0402

R14, R22, R23, R24 | 47k | 4 | RES0402
R17, R25, R26, R27 | 1k | 4 | RES0402
R20, R29 | 15k | 2 | RES0402
R28, R30 | 37k4 | 2 | RES0402
R32 | 100R | 1 | RES0402
R36 | 8k06 | 1 | RES0402
R37 | 1M | 1 | RES0402

R12 | 25k5 | 1 | RES0402

R55, R56, R87, R88 | 5k1 | 4 | RES0402
R57, R58 | 27R | 2 | RES0402

R63, R64, R65, R66, R69, R70 | 560R | 6 | RES0402
R67, R68, R71, R72, R75, R76, R77, R78 | dnp | 8 | RES0402

R83 | 42k2 | 1 | RES0402
R84 | 5k | 1 | RES0402

R90, R91, R92, R93, R96 | 100k | 5 | RES0402
R97, R99, R101 | tbd | 3 | RES0402
R98, R100, R102 | tdb | 3 | RES0402
SD1 | 104031-0811 | 1 | MOLX-104031-0811_V
SOM1, SOM2 | ADM6-60-01.5-L-4-2-A-TR | 2 | SAMTEC_ADM6-60-01.5-L-4-2-A-TR
SW1, SW3 | KSS241GLFS | 2 | KSS241GLFS
SW2 | 416131160804 | 1 | FP-416131160804-MFG
U1 | PCA9617ATP | 1 | FP-SOT1069-2-MFG
U2 | TCA9546APWR | 1 | FP-PW0016A-MFG
U3 | MAX20008AFOC/VY+ | 1 | 21-100155B_F173A3FY+1_MXM
U4 | INA3221AIRGVR | 1 | RGV0016A_V
U5 | MAX6710QUT+T | 1 | FP-U6-1-MFG
U6, U8, U9, U10 | MPM3632CGQV-P | 4 | QFN3p0x5p0x1p6_MPM3632C_MNP
U7 | ISO7140CCDBQ | 1 | DBQ0016A
U11 | NVT4858HKZ | 1 | NVT4858_NXP
U12 | USB3320C-EZK-TR | 1 | FP-32QFN-3304-5X5B-IPC_C

U13, U23, U42, U44 | TXU0104BQAR | 4 | FP-BQA0014A-MFG

U16 | FPF1320UCX | 1 | WLCSP6_1X1.5_ONS-M
U21 | FT234XD-R | 1 | FP-DFN-12-IPC_B
U22 | MAX3378EEUD+ | 1 | MAXM-U14+1_V
U35 | MIC2288YD5-TR | 1 | FP-TSOT-5LD-PL-1-MFG
U36 | HD3SS460RHRT | 1 | FP-RHR0028A-IPC_C
U37 | TPS25820DSSR | 1 | DSS12_P9X2_TEX
U38, U39, U40 | TPD4E05U06DQAR | 3 | DQA0010A
U41 | TPD4S012DRYR | 1 | FP-DRY0006A-MFG
U43 | SN65LVDM176D | 1 | D8
Y1 | FA-23824.000 | 1 | FP-FA-238_27_0000MB-C3-MFG
Y3 | SIT9121AC-2B2-33E52.000000 | 1 | FP-SiT9121-B-MFG
Y4 | SIT9121AI-2B2-33E27.000000 | 1 | FP-SiT9121-B-MFG

Project:

Rev: r3 | Format: | Ch. Vogt | Page * of *

C:\Users\Christian\Documents\Projects\ETH_PROJ_k26_fpga_drone_baseboard\documentation\k26_baseboard_assembly_boM.PCBDwf
