ETH-PBL/SwiftEagle/Hardware/IMUboard/Schematic.pdf

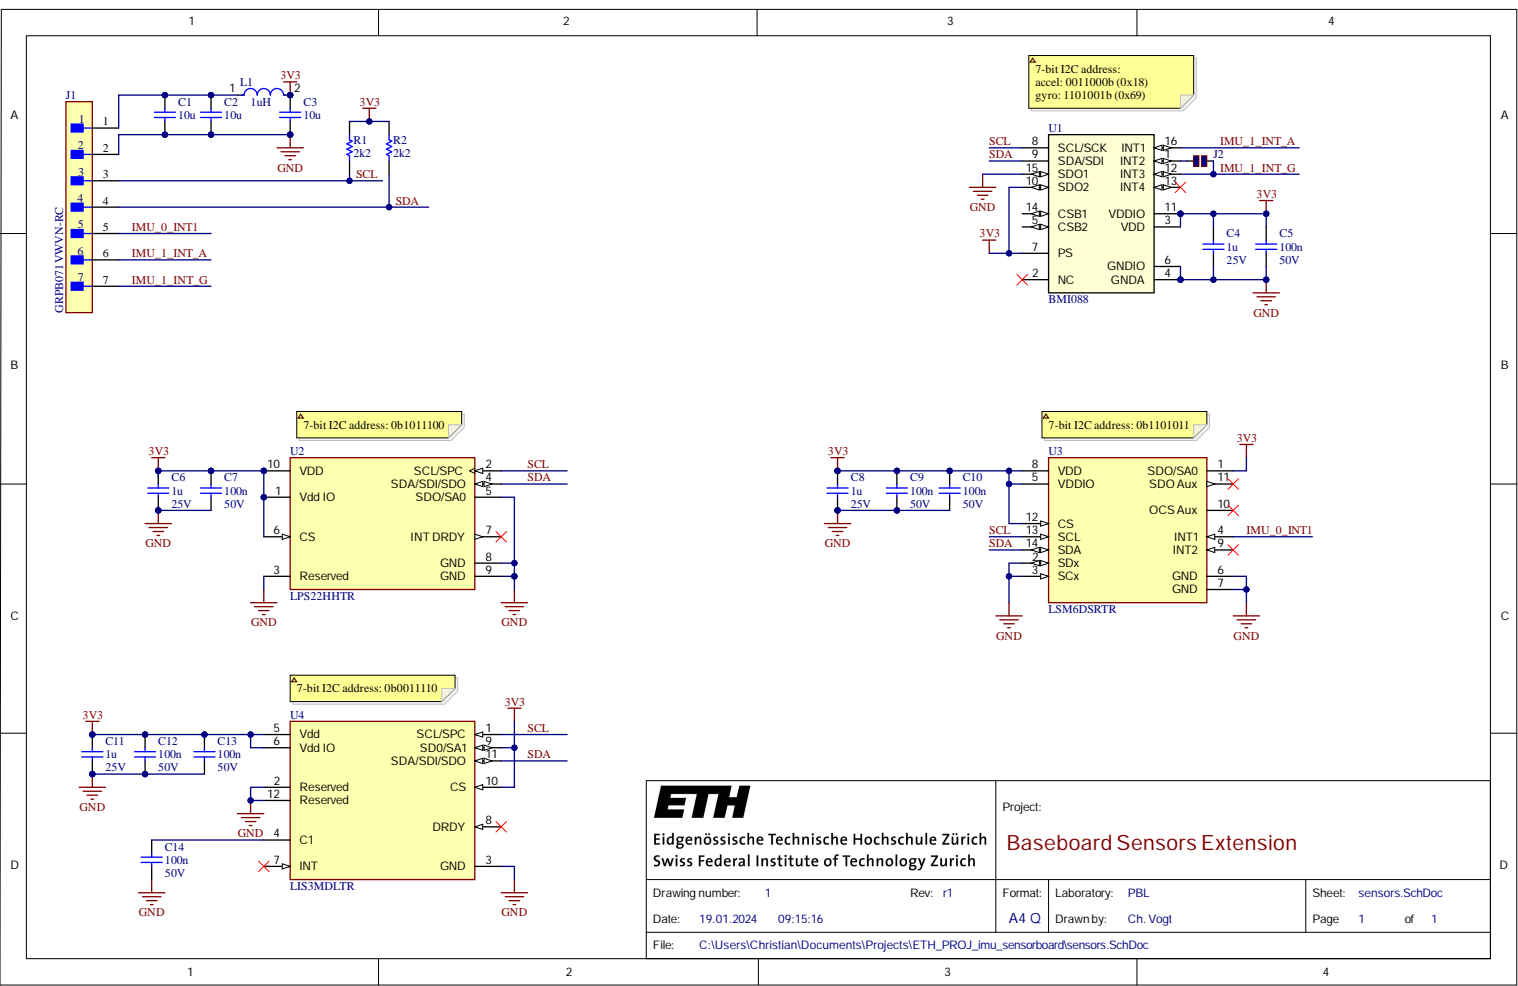
[picture p19: page 1]

3V3 | 7-bit I2C address:

C:\Users\Christian\Documents\Projects\ETH_PROJ_imu_sensorboard\sensors.SchDoc

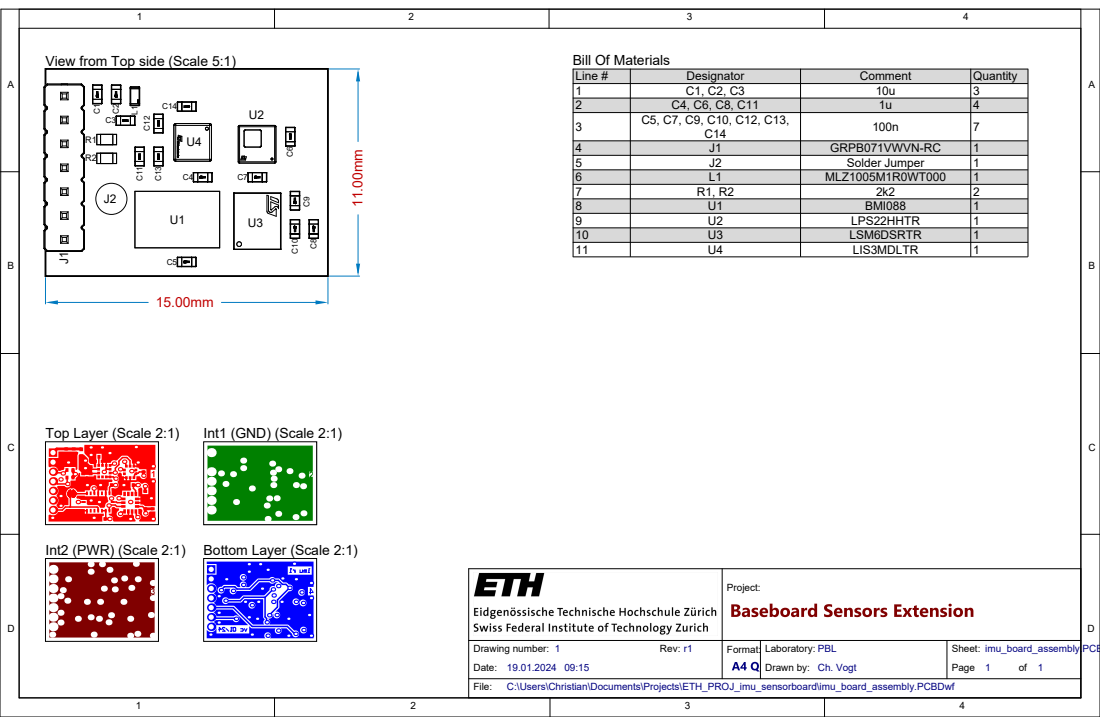
[picture p20: page 2]

View from Top side (Scale 5:1)

Int2 (PWR) (Scale 2:1) Bottom Layer (Scale 2:1)

C:\Users\Christian\Documents\Projects\ETH_PROJ_imu_sensorboard\imu_board_assembly.PCBDwf
