ETH-PBL/SwiftEagle/(list of files, drawings)

Other design files:
Hardware/Baseboard/k26_baseboard.SchDoc
Hardware/Baseboard/k26_baseboard_cameras.SchDoc
Hardware/Baseboard/k26_baseboard_connectors1.SchDoc
Hardware/Baseboard/k26_baseboard_connectors2.SchDoc
Hardware/Baseboard/k26_baseboard_dp.SchDoc
Hardware/Baseboard/k26_baseboard_fan.SchDoc
Hardware/Baseboard/k26_baseboard_power_supply.SchDoc
Hardware/Baseboard/k26_baseboard_reset.SchDoc
Hardware/Baseboard/k26_baseboard_sensors.SchDoc
Hardware/Baseboard/k26_baseboard_telemetry_extconn.SchDoc
Hardware/Baseboard/k26_baseboard_usb.SchDoc
Hardware/Baseboard/k26_baseboard_usb_c_conn.SchDoc
Hardware/Baseboard/k26_FPGA_drone_baseboard.PrjPcb
Hardware/IMUboard/imu_board.PrjPcb
Hardware/IMUboard/imu_board_r1.PcbDoc
Hardware/IMUboard/sensors.SchDoc
