ETH-PBL/SwiftEagle/ProgrammableLogic/ip_designs/axi_to_16_registers/ip_package/drivers/axi_to_16_registers_v1_0/src/axi_to_16_registers.h

#ifndef AXI_TO_16_REGISTERS_H
#define AXI_TO_16_REGISTERS_H


/****************** Include Files ********************/
#include "xil_types.h"
#include "xstatus.h"

#define AXI_TO_16_REGISTERS_S00_AXI_SLV_REG0_OFFSET 0
#define AXI_TO_16_REGISTERS_S00_AXI_SLV_REG1_OFFSET 4
#define AXI_TO_16_REGISTERS_S00_AXI_SLV_REG2_OFFSET 8
#define AXI_TO_16_REGISTERS_S00_AXI_SLV_REG3_OFFSET 12
#define AXI_TO_16_REGISTERS_S00_AXI_SLV_REG4_OFFSET 16
#define AXI_TO_16_REGISTERS_S00_AXI_SLV_REG5_OFFSET 20
#define AXI_TO_16_REGISTERS_S00_AXI_SLV_REG6_OFFSET 24
#define AXI_TO_16_REGISTERS_S00_AXI_SLV_REG7_OFFSET 28
#define AXI_TO_16_REGISTERS_S00_AXI_SLV_REG8_OFFSET 32
#define AXI_TO_16_REGISTERS_S00_AXI_SLV_REG9_OFFSET 36
#define AXI_TO_16_REGISTERS_S00_AXI_SLV_REG10_OFFSET 40
#define AXI_TO_16_REGISTERS_S00_AXI_SLV_REG11_OFFSET 44
#define AXI_TO_16_REGISTERS_S00_AXI_SLV_REG12_OFFSET 48
#define AXI_TO_16_REGISTERS_S00_AXI_SLV_REG13_OFFSET 52
#define AXI_TO_16_REGISTERS_S00_AXI_SLV_REG14_OFFSET 56
#define AXI_TO_16_REGISTERS_S00_AXI_SLV_REG15_OFFSET 60


/**************************** Type Definitions *****************************/
/**
 *
 * Write a value to a AXI_TO_16_REGISTERS register. A 32 bit write is performed.
 * If the component is implemented in a smaller width, only the least
 * significant data is written.
 *
 * @param   BaseAddress is the base address of the AXI_TO_16_REGISTERSdevice.
 * @param   RegOffset is the register offset from the base to write to.
 * @param   Data is the data written to the register.
 *
 * @return  None.
 *
 * @note
 * C-style signature:
 * 	void AXI_TO_16_REGISTERS_mWriteReg(u32 BaseAddress, unsigned RegOffset, u32 Data)
 *
 */
#define AXI_TO_16_REGISTERS_mWriteReg(BaseAddress, RegOffset, Data) \
  	Xil_Out32((BaseAddress) + (RegOffset), (u32)(Data))

/**
 *
 * Read a value from a AXI_TO_16_REGISTERS register. A 32 bit read is performed.
 * If the component is implemented in a smaller width, only the least
 * significant data is read from the register. The most significant data
 * will be read as 0.
 *
 * @param   BaseAddress is the base address of the AXI_TO_16_REGISTERS device.
 * @param   RegOffset is the register offset from the base to write to.
 *
 * @return  Data is the data from the register.
 *
 * @note
 * C-style signature:
 * 	u32 AXI_TO_16_REGISTERS_mReadReg(u32 BaseAddress, unsigned RegOffset)
 *
 */
#define AXI_TO_16_REGISTERS_mReadReg(BaseAddress, RegOffset) \
    Xil_In32((BaseAddress) + (RegOffset))

/************************** Function Prototypes ****************************/
/**
 *
 * Run a self-test on the driver/device. Note this may be a destructive test if
 * resets of the device are performed.
 *
 * If the hardware system is not built correctly, this function may never
 * return to the caller.
 *
 * @param   baseaddr_p is the base address of the AXI_TO_16_REGISTERS instance to be worked on.
 *
 * @return
 *
 *    - XST_SUCCESS   if all self-test code passed
 *    - XST_FAILURE   if any self-test code failed
 *
 * @note    Caching must be turned off for this function to work.
 * @note    Self test may fail if data memory and device are not on the same bus.
 *
 */
XStatus AXI_TO_16_REGISTERS_Reg_SelfTest(void * baseaddr_p);

#endif // AXI_TO_16_REGISTERS_H
